shinchiryota/Circuit/README.md

# Circuit
2022以降の回路をまとめる

## [諸注意](諸注意)
+ [使用するソフトウェア](諸注意/使用するソフトウェア/readme.md)
+ [ファイル構成](諸注意/ファイル構成/readme.md)
+ [命名規則](諸注意/命名規則/readme.md)

## [2022](https://github.com/shinchiryota/Circuit/blob/main/2022/README.md)
+ servo_solenoidvalve_of_Tatebayashi

+ unitbase_keinz_2022

+ controller_keinz_2022
## [2023](https://github.com/shinchiryota/Circuit/blob/main/2023/README.md)
+ controller_keinz_2023

+ sensormain_of_sawada

+ servosolenoidvalve_of_tanbo

+ unitbase_anayuki
## [2024](https://github.com/shinchiryota/Circuit/blob/main/2024/README.md)
+ Power_of_Exodia

+ Unitbase_of_exoia
+ ### [nhk2024](https://github.com/shinchiryota/Circuit/blob/main/2024/nhk2024/README.md)
