shinchiryota/Circuit/2024/README.md

# 2024年度の回路
+ Power_of_Exodia
 
+ Unitbase_of_exodia
## [nhk2024](https://github.com/shinchiryota/Circuit/tree/main/2024/nhk2024)

# [始めに戻る](https://github.com/shinchiryota/Circuit/blob/main/README.md)
