shinchiryota/Circuit/2023/README.md

# 2023

# [始めに戻る](https://github.com/shinchiryota/Circuit/blob/main/README.md)
