shinchiryota/Circuit/諸注意/使用するソフトウェア/readme.md

# 使用するソフトウェア
---
## EAGLE
[ここ]() からダウンロードする。

詳細はGRCCの[回路資料]()を見ること。

サ終するのと、バグが頻繁に起きるのでインストールミスるひともいるかも。
## Kicad
[ここ](https://www.kicad.org/download/) からダウンロードする。

手順通り従えばインストールできるはず。

めっちゃ丁寧でわかりやすい。
