shinchiryota/Circuit/2024/nhk2024/README.md

# 高専ロボコン2024で使った回路
+ Controller 

+ Sensormain

+ Unitbase

+ Servosolenoidvalve

+ FEP02 

# [始めに戻る](https://github.com/shinchiryota/Circuit/blob/main/README.md)
