shinchiryota/Circuit/諸注意/readme.md

# 目次

+ [使用するソフトウェア](使用するソフトウェア/readme.md)
+ [ファイル構成](ファイル構成/readme.md)
+ [命名規則](命名規則/readme.md)
