shinchiryota/Circuit/2022/unitbase_keinz_2022/README.md

# Unitbase_Keinz_2022

高専ロボコン2022で使用されるUnitbase回路。  
現在の内容は印字等の修正が含まれているため部室にある回路とは厳密には異なる。  
部室にある回路のデータは、以下のcommitの中にある。  

commit #22d5f8b0ac3ca70e439e2381a5ce0f51943bfda6
