shinchiryota/Circuit/2024/Unitbase_of_exodia-main/README.md

# Unitbase_of_exodia
Unitbase_anayukiの改良版
