shinchiryota/Circuit/fep/Fep_Exodia/ver2/README.md

# FEP_of_Exodia
fep02用に新しく開発したfep基板です。god_of_fepを参考にしてます。

## 回路図
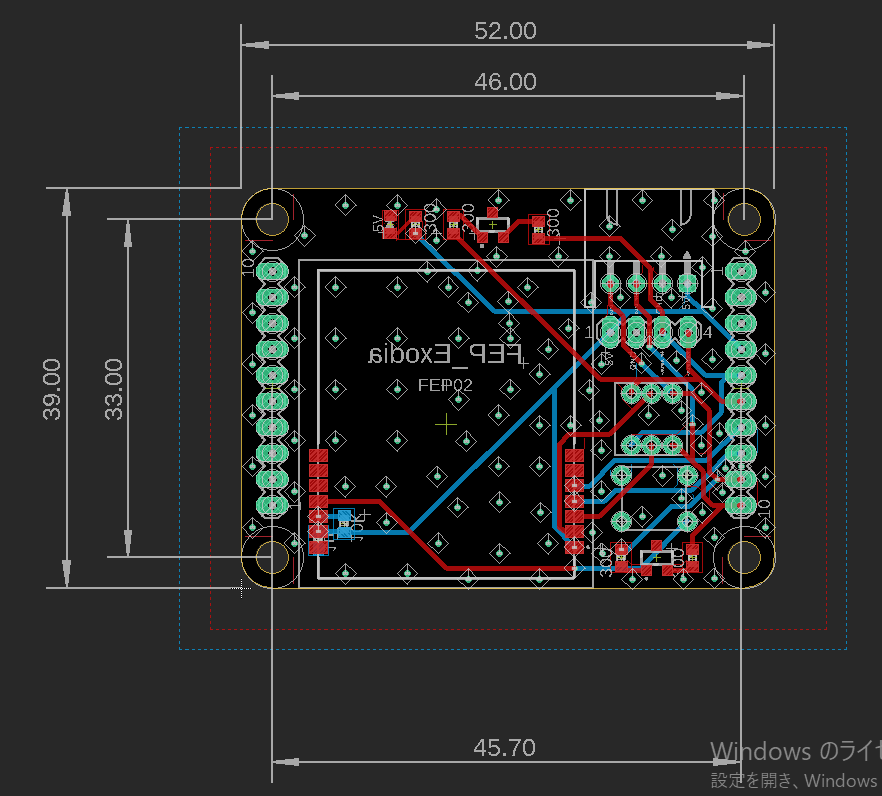
[picture p1: fep/Fep_Exodia/ver2/docs/fep_of_exodia.png]
brd_image


## スケマティック
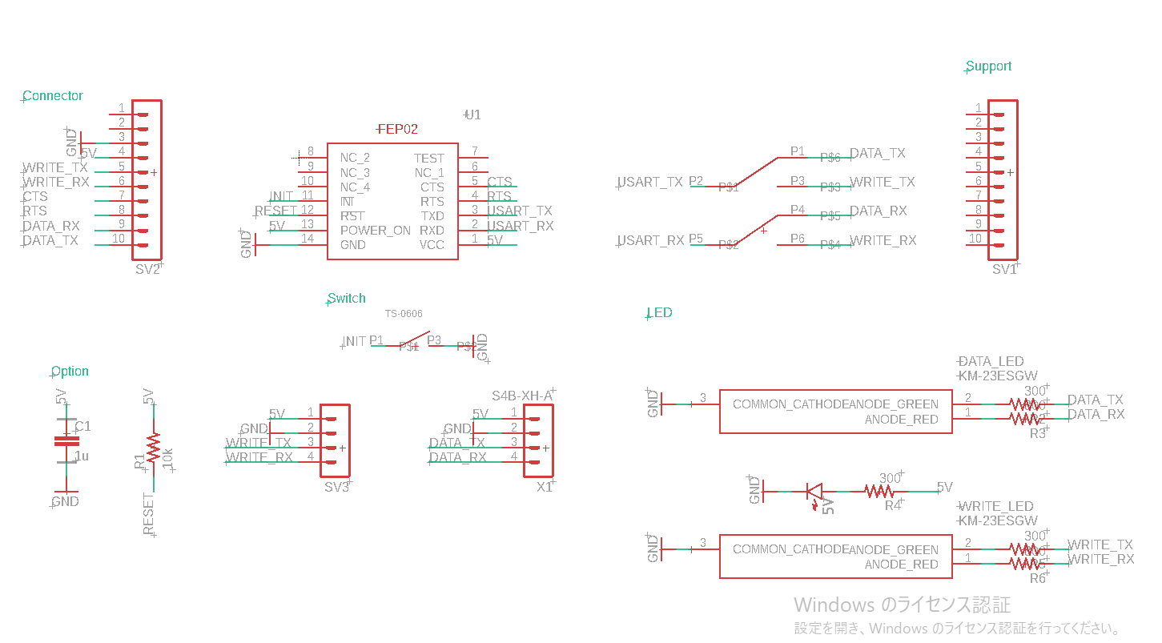
[picture p2: fep/Fep_Exodia/ver2/docs/fep_of_exodia_sch.png]
sch_image
