shinchiryota/Circuit/fep/god_of_fep/God_of_FEP_Parts.xlsx

Sheet: Parts_List
回路製作枚数 | 部品名 | ジャンル | 使用場所 | 購入場所 | URL | 単価 | 個数/枚 | 必要個数 | 合計金額 | その他 | １枚あたりの製作コスト
10 | FEP01 | FEP | 本体 |  |  |  | 1 | 10 | 0 |  | 1685
 | RED_LED | LED | 電源LED | 秋月電子 | URL (http://akizukidenshi.com/catalog/g/gI-03978/) | 10 | 1 | 10 | 100 | I-03978
 | KM-23YSGC | LED | チェックLED | 秋月電子 | URL (http://akizukidenshi.com/catalog/g/gI-06845/) | 10 | 2 | 20 | 200 | I-06845
 | S04B-XASK-1 | XAコネクタ | コネクタ部 | RS | URL (https://jp.rs-online.com/web/p/pcb-headers/6028228/) | 78.5 | 1 | 10 | 785
 | タクトスイッチ(赤色) | スイッチ |  | 秋月電子 | URL (http://akizukidenshi.com/catalog/g/gP-03646/) | 10 | 1 | 10 | 100 | P-03646
 | PS-70S_RED | スイッチ |  | 秋月電子 | URL (http://akizukidenshi.com/catalog/g/gP-08784/) | 50 | 1 | 10 | 500 | P-08784
 | 1uF | 表面実装コンデンサ |  | ウルト |  | 0 | 1 | 10 | 0
 | ピンヘッダ | ピンヘッダ | コネクタ部 | 秋月電子 |  |  |  | 0 | 0

Sheet: Data
部品名 | ジャンル | 購入場所 | URL | 単価 | その他
