shinchiryota/Circuit/2022/servo_solenoidvalve_of_Tatebayashi/Servosolenoidvalve_of_Tatebayashi.xlsx

回路製作枚数 | 部品名 | ジャンル | 使用場所 | 購入場所 | URL | 単価 | 個数/枚 | 必要個数 | 合計金額 | その他 | １枚あたりの製作コスト
2+3 | 0.1uコンデンサ |  |  |  |  |  | 6 | 30 |  |  | 0
 | 10nコンデンサ |  |  |  |  |  | 1 | 5
 | 10uコンデンサ |  |  |  |  |  | 1 | 5
 | 1uコンデンサ |  |  |  |  |  | 1 | 5
 | 4.7uコンデンサ |  |  |  |  |  | 1 | 5
 | 25PK470MEFC8X11.5 | 470u電解コンデンサー |  | 秋月電子 | URL (https://akizukidenshi.com/catalog/g/gP-03129/) | 20 | 1 | 5
 | 120抵抗 |  |  |  |  |  | 1 | 5
 | 300抵抗 |  |  |  |  |  | 20 | 100
 | 1k抵抗 |  |  |  |  |  | 83 | 415
 | 10k抵抗 |  |  |  |  |  | 18 | 90
 | 2SC2712GR | トランジスタNch |  | 秋月電子 | URL (https://akizukidenshi.com/catalog/g/gI-00761/) | 5 | 28 | 140
 | F302RBT6 | マイコン |  |  |  |  | 1 | 5
 | LD1117S33CTR | 3V3レギュレータ |  | チップワンストップ | URL (https://www.chip1stop.com/view/dispDetail/DispDetail?partId=STMI-0020157) | 96.2 | 1 | 5
 | NCV7351D1ER2G | CANトランシーバ |  |  |  |  | 1 | 5
 | TD62083AFG,N,EL | トランジスタアレイ |  | 秋月電子 | URL (https://akizukidenshi.com/catalog/g/gI-06227/) | 30 | 1 | 5
 | TLP293-4_GB | フォトカプラアレイ |  | 秋月電子 | URL (https://akizukidenshi.com/catalog/g/gI-16115/) | 60 | 5 | 25
 | USB2段メス |  |  |  |  |  | 1 | 5
 | XH2ピン縦 |  |  |  |  |  | 1 | 5
 | XH2ピン横 |  |  |  |  |  | 10 | 50
 | XH3ピン横 |  |  |  |  |  | 13 | 65
 | XH4ピン横 |  |  |  |  |  | 1 | 5
 | 青色LED |  |  |  |  |  | 6 | 30
 | 赤色LED |  |  |  |  |  | 4 | 20
 | 黄色LED |  |  |  |  |  | 21 | 105
 | 緑色LED |  |  |  |  |  | 21 | 105
 | タクトスイッチ |  |  |  |  |  | 1 | 5
 | ピンソケットL6 |  |  |  |  |  | 1 | 5
 | ピンヘッダ1*3 |  |  |  |  |  | 3 | 15
 | 小型高効率ＤＣＤＣコンバーター可変電源キット（降圧） |  |  | 秋月電子 | URL (https://akizukidenshi.com/catalog/g/gK-07728/) | 1280 | 1 | 5
