shinchiryota/Circuit/2024/nhk2024/Unitbase_chachamaru.ver4/unit_base.kicad_pcb

## KiCad design 2024/nhk2024/Unitbase_chachamaru.ver4/unit_base.kicad_pcb (2024-07-15)

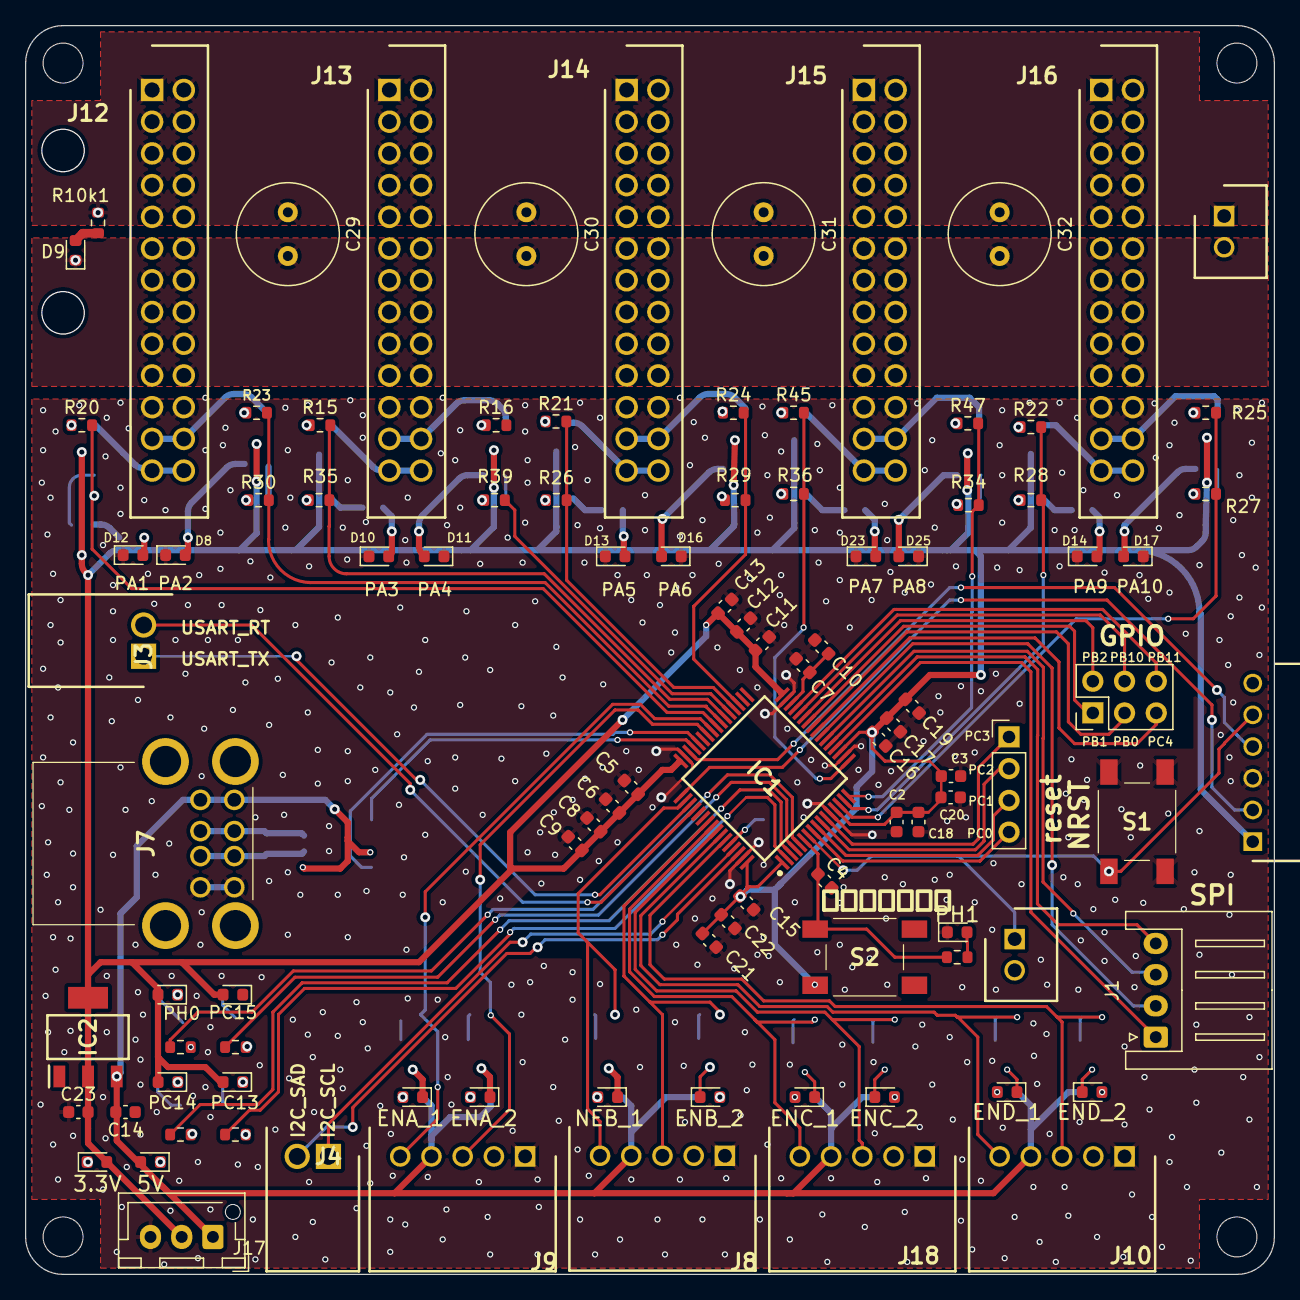
[picture p3: board unit_base.kicad_pcb from above]

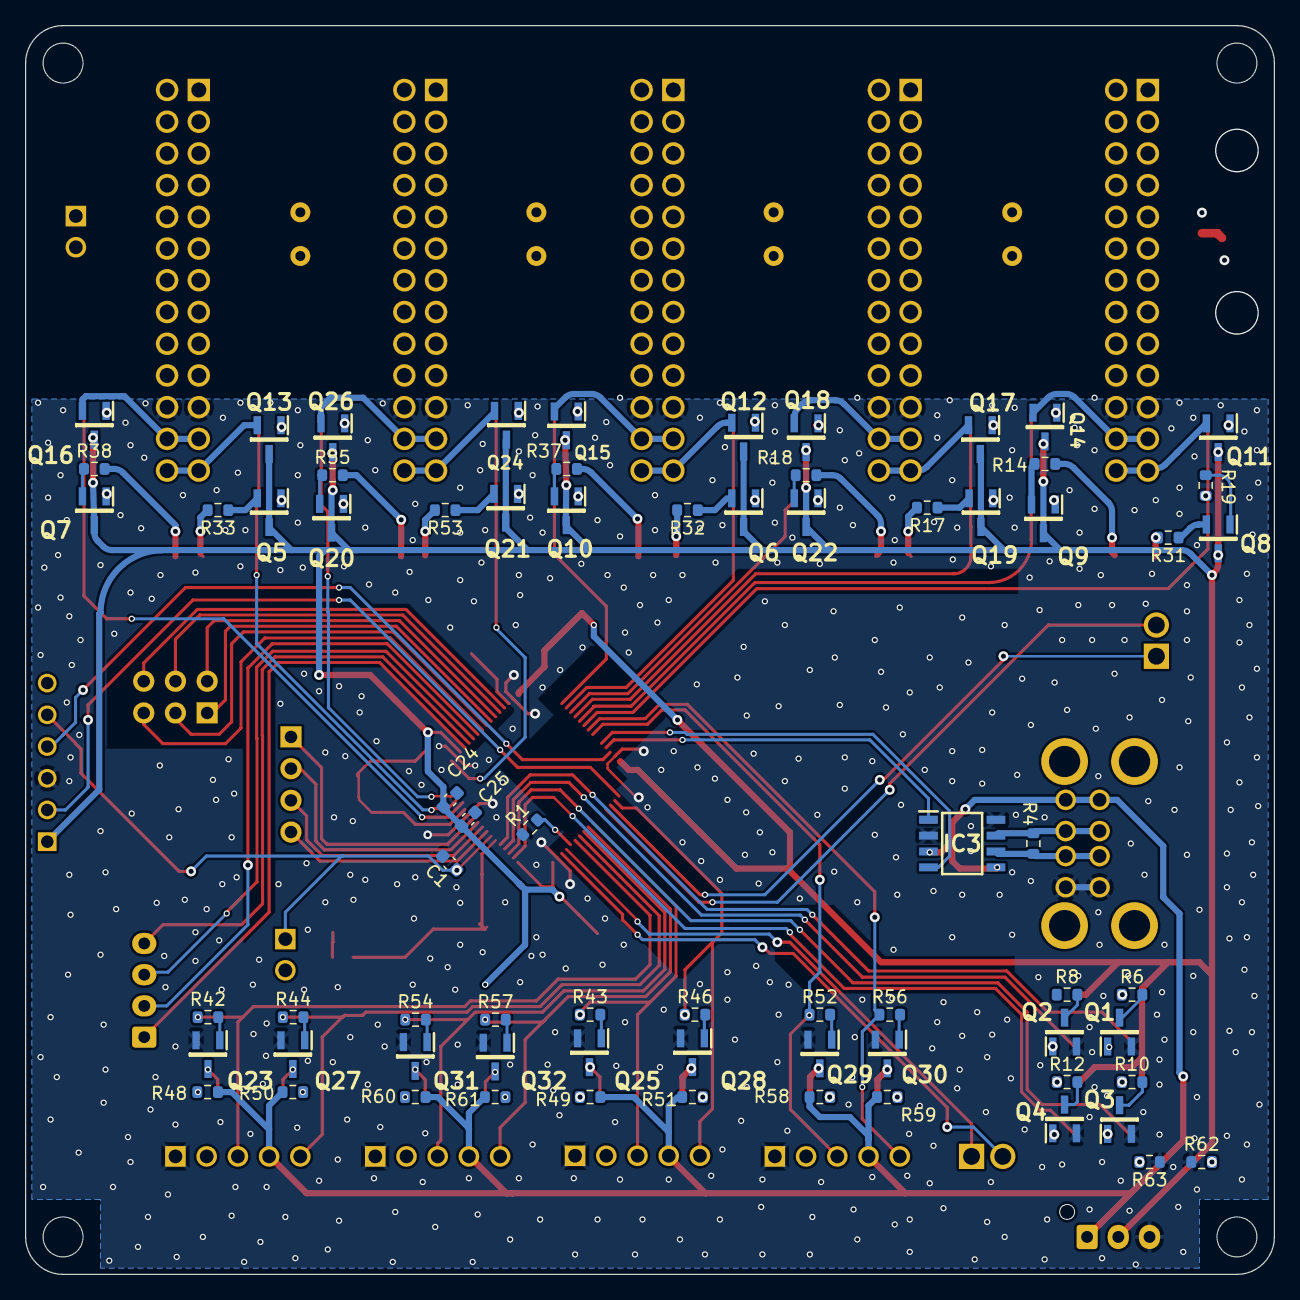
[picture p4: board unit_base.kicad_pcb from below]

Board: 2 copper layers, 100.0 x 100.0 mm, 169 parts (71 on the bottom side), 136 nets.

Parts:
3.3V, 5V: LED; LED_0603_1608Metric
C1, C4: C0.1u; C_0603_1608Metric
C2, C18, C24: 100n; C_0603_1608Metric
C3, C20, C25: 1u; C_0603_1608Metric
C5, C6, C8, C9, C11, C12, C13, C14, C15, C16, C17, C19: C100n; C_0603_1608Metric
C7, C10: C2.2u; C_0603_1608Metric
C21: C4.7u; C_0603_1608Metric
C22: 100u; C_0603_1608Metric
C23: C10u; C_0603_1608Metric
C29, C30, C31, C32: C; C_Radial_D8.0mm_H11.5mm_P3.50mm
D8, D9, D10, D11, D12, D13, D14, D16, D17, D23, D25: LED; LED_0603_1608Metric
ENA_1, ENA_2: LED; LED_0603_1608Metric
ENB_2: LED; LED_0603_1608Metric
ENC_1, ENC_2: LED; LED_0603_1608Metric
END_1, END_2: LED; LED_0603_1608Metric
IC1: STM32F732RET6; QFP50P1200X1200X160-64N
IC2: LM317_SOT-223_; SOT230P700X180-4N
IC3: NCV7351D1ER2G; SOIC127P600X175-8N
J1: S4B-XH-A_LF__SN_; JST_XH_S4B-XH-A_1x04_P2.50mm_Horizontal
J2, J11: B2B-XH-A; SHDR2W64P0X250_1X2_740X575X700P
J3, J4: S2B-XH-A_LF__SN_; SHDRRA2W80P0X250_1X2_740X1150X610P
J6: FH-1X06RG; RHDRRA6W58P0X254_1X6_1549X850X265P
J7: USB-4AF203AS; USB4AF203AS
J8, J9, J10, J18: S5B-XH-A_LF__SN_; SHDRRA5W64P0X250_1X5_1490X1150X610P
J12, J13, J14, J15, J16: HIF3FB-26DA-2.54DSA_71_; RHDR26W71P254_2X13_3759X600X980Pソケット
J17: B3B-XH-A; JST_XH_B3B-XH-AM_1x03_P2.50mm_Vertical
NEB_1: LED; LED_0603_1608Metric
PC13, PC14, PC15: LED; LED_0603_1608Metric
PH0, PH1: LED; LED_0603_1608Metric
Q1, Q2, Q3, Q4, Q5, Q6, Q7, Q8, Q9, Q10, Q11, Q12, Q13, Q14, Q15, Q16, Q17, Q18, Q19, Q20, Q21, Q22, Q23, Q24, Q25, Q26, Q27, Q28, Q29, Q30, Q31, Q32: 2SC2712-GR_TE85L,F; SOT95P260X156-3N
R1: R10k; R_0603_1608Metric
R2, R4, R6, R7, R8, R9, R10, R10k1, R11, R12, R13, R14, R15, R16, R17, R18, R19, R20, R21, R22, R23, R24, R25, R26, R27, R28, R29, R30, R31, R32, R33, R34, R35, R36, R37, R38, R39, R42, R43, R44, R45, R46, R47, R48, R49, R50, R51, R52, R53, R54, R55, R56, R57, R58, R59, R60, R61, R62, R63: R; R_0603_1608Metric
S1, S2: TSHA-T-2.5B2-19E; TSHAT25B219E

Connections:
3.3V: 3.3V.2 (A), C2.1, C3.1, C5.1, C6.1, C8.1, C9.1, C11.1, C12.1, C13.1, C15.1, C16.1, C17.1, C18.1, C19.1, C20.1, C21.1, C22.1, C23.2, C24.1, C25.1, IC1.1 (VBAT), IC1.13 (VREF+), IC1.19 (VDD_1), IC1.32 (VDD_2), IC1.48 (VDD_3), IC1.64 (VDD_4), IC2.2 (OUTPUT_1), IC2.4 (OUTPUT_2), J6.1, J17.2, PC13.2 (A), PC14.2 (A), PC15.2 (A), PH0.2 (A), Q5.3 (COLLECTOR), Q6.3 (COLLECTOR), Q7.3 (COLLECTOR), Q8.3 (COLLECTOR), Q9.3 (COLLECTOR), Q10.3 (COLLECTOR), Q11.3 (COLLECTOR), Q12.3 (COLLECTOR), Q13.3 (COLLECTOR), Q14.3 (COLLECTOR), Q15.3 (COLLECTOR), Q16.3 (COLLECTOR), Q17.3 (COLLECTOR), Q18.3 (COLLECTOR), Q19.3 (COLLECTOR), Q20.3 (COLLECTOR), Q21.3 (COLLECTOR), Q22.3 (COLLECTOR), Q24.3 (COLLECTOR), Q26.3 (COLLECTOR), S2.C1 (COM_1)
12V: C29.1, C30.1, C31.1, C32.1, J11.1, J12.1, J12.2, J12.3, J12.4, J12.5, J12.6, J12.7, J12.8, J12.9, J12.10, J13.1, J13.2, J13.3, J13.4, J13.5, J13.6, J13.7, J13.8, J13.9, J13.10, J14.1, J14.2, J14.3, J14.4, J14.5, J14.6, J14.7, J14.8, J14.9, J14.10, J15.1, J15.2, J15.3, J15.4, J15.5, J15.6, J15.7, J15.8, J15.9, J15.10, J16.1, J16.2, J16.3, J16.4, J16.5, J16.6, J16.7, J16.8, J16.9, J16.10, R10k1.2
12V_GND: C29.2, C30.2, C31.2, C32.2, D9.1 (K), J11.2, J12.11, J12.12, J12.13, J12.14, J12.15, J12.16, J12.17, J12.18, J12.19, J12.20, J13.11, J13.12, J13.13, J13.14, J13.15, J13.16, J13.17, J13.18, J13.19, J13.20, J14.11, J14.12, J14.13, J14.14, J14.15, J14.16, J14.17, J14.18, J14.19, J14.20, J15.11, J15.12, J15.13, J15.14, J15.15, J15.16, J15.17, J15.18, J15.19, J15.20, J16.11, J16.12, J16.13, J16.14, J16.15, J16.16, J16.17, J16.18, J16.19, J16.20
/5V: 5V.2 (A), C14.2, IC2.3 (INPUT), IC3.3 (VCC), IC3.5 (EN), J7.1, J7.5, J8.4, J9.4, J10.4, J17.1, J18.4, R48.2, R49.2, R50.2, R51.2, R58.2, R59.2, R60.2, R61.2
/5V_GND: C14.1, IC2.1 (ADJ)
/12V/PA1: J12.25, J12.26, Q11.2 (EMITTER)
/12V/PA2: J12.23, J12.24, Q14.2 (EMITTER)
/12V/PA3: J13.25, J13.26, Q17.2 (EMITTER)
/12V/PA4: J13.23, J13.24, Q18.2 (EMITTER)
/12V/PA5: J14.25, J14.26, Q12.2 (EMITTER)
/12V/PA6: J14.23, J14.24, Q15.2 (EMITTER)
/12V/PA7: J15.25, J15.26, Q24.2 (EMITTER)
/12V/PA8: J15.23, J15.24, Q26.2 (EMITTER)
/12V/PA9: J16.25, J16.26, Q13.2 (EMITTER)
/12V/PA10: J16.23, J16.24, Q16.2 (EMITTER)
/CAN1_RX: IC1.44 (PA11), IC3.4 (RXD)
/CAN1_TX: IC1.45 (PA12), IC3.1 (TXD)
/CANH: IC3.7 (CANH), J7.2, J7.6, R4.1
/CANL: IC3.6 (CANL), J7.3, J7.7, R4.2
/EncoderA_1: IC1.41 (PA8), J9.5, R56.1
/EncoderA_2: IC1.42 (PA9), J9.3, R52.1
/EncoderB_1: IC1.50 (PA15), J8.5, R46.1
/EncoderB_2: IC1.55 (PB3), J8.3, R43.1
/EncoderC_1: IC1.56 (PB4), J18.5, R57.1
/EncoderC_2: IC1.57 (PB5), J18.3, R54.1
/EncoderD_1: IC1.58 (PB6), J10.5, R44.1
/EncoderD_2: IC1.59 (PB7), J10.3, R42.1
/I2C1_SCL: IC1.61 (PB8), J4.1
/I2C1_SDA: IC1.62 (PB9), J4.2
/NRST: C1.1, IC1.7 (NRST), J2.1, J6.5, S1.A1 (NO_1)
/PH0: IC1.5 (PH0-OSC_IN), R7.2
/PH1: C4.1, IC1.6 (PH1-OSC_OUT), R2.2, S2.A1 (NO_1)
/SPI1_MISO: IC1.22 (PA6), J1.3
/SPI1_MOSI: IC1.23 (PA7), J1.2
/SPI1_NSS: IC1.20 (PA4), J1.1
/SPI1_SCK: IC1.21 (PA5), J1.4
/SWCLK: IC1.49 (PA14), J6.2
/SWDIO: IC1.46 (PA13), J6.4
/UART4_RT: IC1.52 (PC11), J3.2
/UART4_TX: IC1.51 (PC10), J3.1
/VCAP: C7.1, C10.1, IC1.30 (VCAP_1)
GND: C1.2, C2.2, C3.2, C4.2, C5.2, C6.2, C7.2, C8.2, C9.2, C10.2, C11.2, C12.2, C13.2, C15.2, C16.2, C17.2, C18.2, C19.2, C20.2, C21.2, C22.2, C23.1, D8.1 (K), D10.1 (K), D11.1 (K), D12.1 (K), D13.1 (K), D14.1 (K), D16.1 (K), D17.1 (K), D23.1 (K), D25.1 (K), IC1.12 (VSSA), IC1.18 (VSS_1), IC1.31 (VSS_2), IC1.47 (VSS_3), IC1.63 (VSS_4), IC3.2 (GND), IC3.8 (S), J6.3, J7.4, J7.8, J8.1, J9.1, J10.1, J12.21, J12.22, J13.21, J13.22, J14.21, J14.22, J15.21, J15.22, J16.21, J16.22, J17.3, J18.1, PH1.1 (K), Q1.2 (EMITTER), Q2.2 (EMITTER), Q3.2 (EMITTER), Q4.2 (EMITTER), Q23.2 (EMITTER), Q25.2 (EMITTER), Q27.2 (EMITTER), Q28.2 (EMITTER), Q29.2 (EMITTER), Q30.2 (EMITTER), Q31.2 (EMITTER), Q32.2 (EMITTER), R1.1, R62.1, R63.1, S1.B1 (NO_2), S1.C1 (COM_1), S1.D1 (COM_2)
MDA_1: IC1.40 (PC9), R19.2, R20.2
MDA_2: IC1.39 (PC8), R23.2, R30.2
MDB_1: IC1.38 (PC7), R15.2, R35.2
MDB_2: IC1.37 (PC6), R16.2, R39.2
MDC_1: IC1.36 (PB15), R21.2, R26.2
MDC_2: IC1.35 (PB14), R24.2, R29.2
MDD_1: IC1.17 (PA3), R36.2, R45.2
MDD_2: IC1.16 (PA2), R34.2, R47.2
MDE_1: IC1.15 (PA1), R22.2, R28.2
MDE_2: IC1.14 (PA0-WKUP), R25.2, R27.2
unnamed: PH1.2 (A), R2.1
unnamed: PH0.1 (K), R6.1
unnamed: PC15.1 (K), R8.1
unnamed: PC14.1 (K), R10.1
unnamed: PC13.1 (K), R12.1
unnamed: D8.2 (A), R14.2
unnamed: D9.2 (A), R10k1.1
unnamed: D10.2 (A), R17.2
unnamed: D11.2 (A), R18.2
unnamed: D12.2 (A), R31.2
unnamed: D13.2 (A), R32.2
unnamed: D14.2 (A), R33.2
unnamed: D16.2 (A), R37.2
unnamed: D17.2 (A), R38.2
unnamed: END_2.2 (A), R48.1
unnamed: END_2.1 (K), Q23.3 (COLLECTOR)
unnamed: ENB_2.2 (A), R49.1
unnamed: ENB_2.1 (K), Q25.3 (COLLECTOR)
unnamed: END_1.2 (A), R50.1
unnamed: END_1.1 (K), Q27.3 (COLLECTOR)
unnamed: NEB_1.2 (A), R51.1
unnamed: NEB_1.1 (K), Q28.3 (COLLECTOR)
unnamed: D23.2 (A), R53.2
unnamed: ENA_2.2 (A), R58.1
unnamed: ENA_2.1 (K), Q29.3 (COLLECTOR)
unnamed: D25.2 (A), R55.2
unnamed: ENA_1.2 (A), R59.1
unnamed: ENA_1.1 (K), Q30.3 (COLLECTOR)
unnamed: ENC_2.2 (A), R60.1
unnamed: ENC_2.1 (K), Q31.3 (COLLECTOR)
unnamed: ENC_1.2 (A), R61.1
unnamed: ENC_1.1 (K), Q32.3 (COLLECTOR)
unnamed: 3.3V.1 (K), R62.2
unnamed: 5V.1 (K), R63.2
unnamed: IC1.60 (BOOT0), R1.2
unnamed: Q1.1 (BASE), R7.1
unnamed: Q1.3 (COLLECTOR), R6.2
unnamed: Q2.1 (BASE), R9.1
unnamed: Q2.3 (COLLECTOR), R8.2
unnamed: Q3.1 (BASE), R11.1
unnamed: Q3.3 (COLLECTOR), R10.2
unnamed: Q4.1 (BASE), R13.1
unnamed: Q4.3 (COLLECTOR), R12.2
unnamed: Q5.1 (BASE), R28.1
unnamed: Q5.2 (EMITTER), R33.1
unnamed: Q6.1 (BASE), R26.1
unnamed: Q6.2 (EMITTER), R32.1
unnamed: Q7.1 (BASE), R27.1
unnamed: Q7.2 (EMITTER), R38.1
unnamed: Q8.1 (BASE), R19.1
unnamed: Q8.2 (EMITTER), R31.1
unnamed: Q9.1 (BASE), R30.1
unnamed: Q9.2 (EMITTER), R14.1
unnamed: Q10.1 (BASE), R29.1
unnamed: Q10.2 (EMITTER), R37.1
unnamed: Q11.1 (BASE), R20.1
unnamed: Q12.1 (BASE), R21.1
unnamed: Q13.1 (BASE), R22.1
unnamed: Q14.1 (BASE), R23.1
unnamed: Q15.1 (BASE), R24.1
unnamed: Q16.1 (BASE), R25.1
unnamed: Q17.1 (BASE), R15.1
unnamed: Q18.1 (BASE), R16.1
unnamed: Q19.1 (BASE), R35.1
unnamed: Q19.2 (EMITTER), R17.1
unnamed: Q20.1 (BASE), R34.1
unnamed: Q20.2 (EMITTER), R55.1
unnamed: Q21.1 (BASE), R36.1
unnamed: Q21.2 (EMITTER), R53.1
unnamed: Q22.1 (BASE), R39.1
unnamed: Q22.2 (EMITTER), R18.1
unnamed: Q23.1 (BASE), R42.2
unnamed: Q24.1 (BASE), R45.1
unnamed: Q25.1 (BASE), R43.2
unnamed: Q26.1 (BASE), R47.1
unnamed: Q27.1 (BASE), R44.2
unnamed: Q28.1 (BASE), R46.2
unnamed: Q29.1 (BASE), R52.2
unnamed: Q30.1 (BASE), R56.2
unnamed: Q31.1 (BASE), R54.2
unnamed: Q32.1 (BASE), R57.2
PC13: IC1.2 (PC13), R13.2
PC14: IC1.3 (PC14-OSC32_IN), R11.2
PC15: IC1.4 (PC15-OSC32_OUT), R9.2
