shinchiryota/Circuit/2024/MD_Tanukiti/mD.kicad_pcb

## KiCad design 2024/MD_Tanukiti/mD.kicad_pcb (2024-06-25)

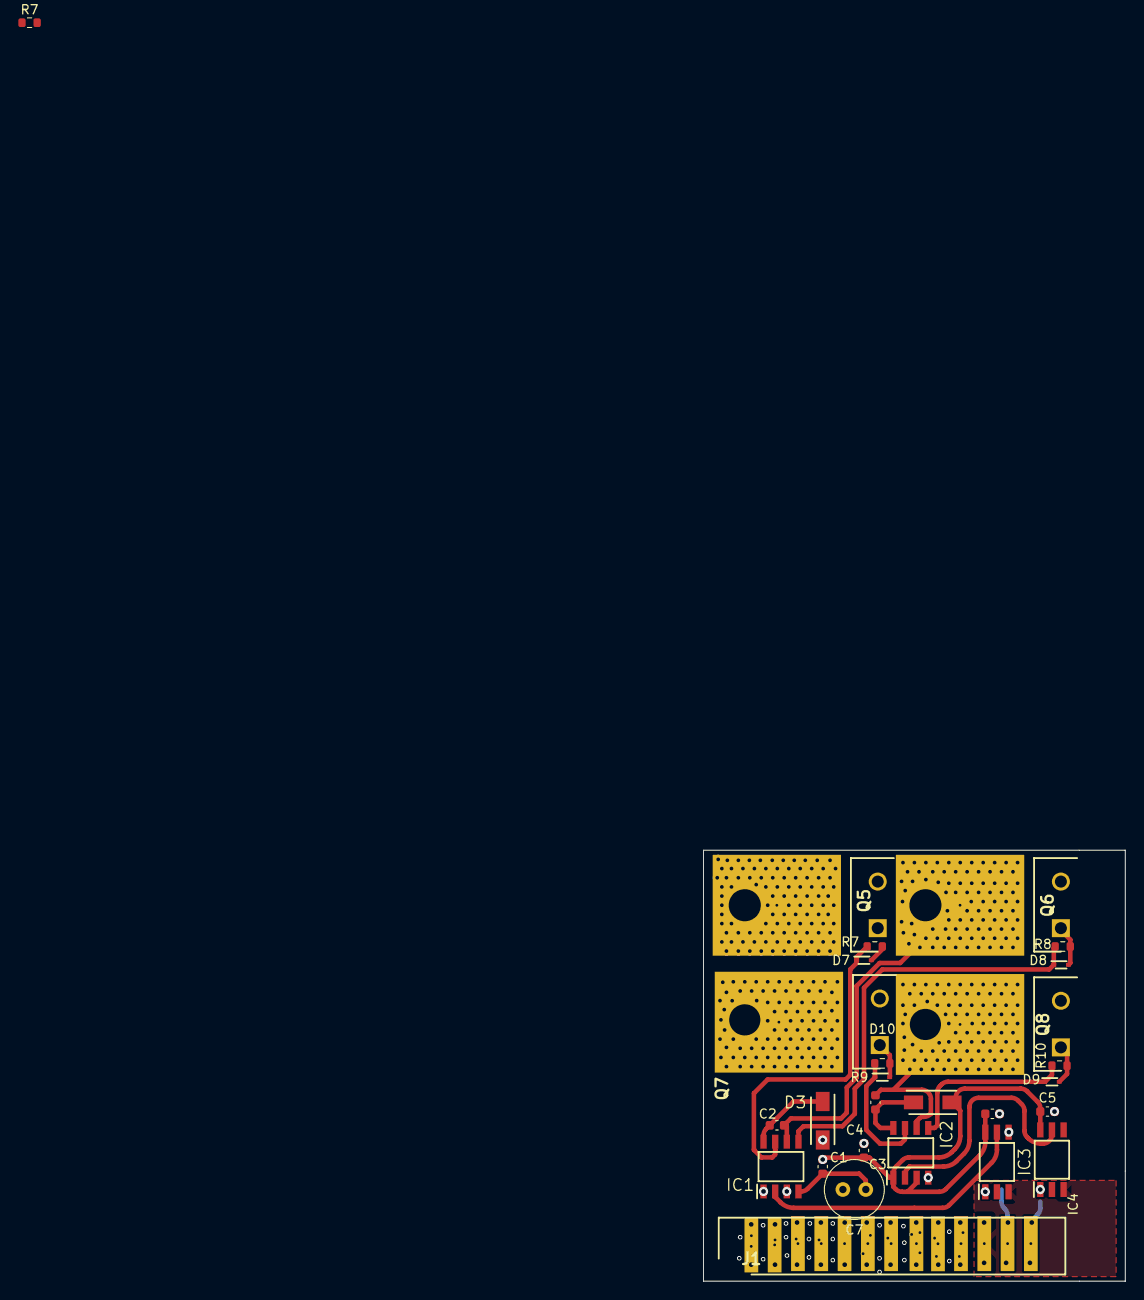
[picture p5: board mD.kicad_pcb from above]

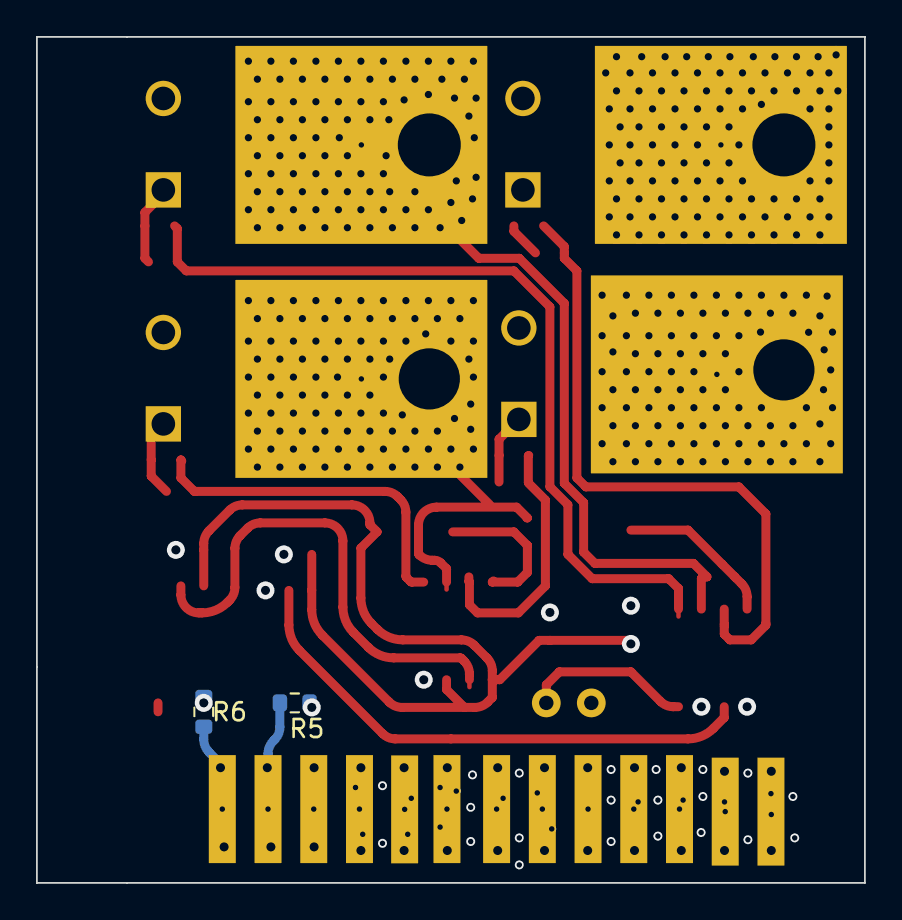
[picture p6: board mD.kicad_pcb from below]

Board: 2 copper layers, 46.0 x 47.0 mm, 29 parts (2 on the bottom side), 22 nets.

Parts:
C1: C_1u; C_0603_1608Metric
C2, C4: C0.1u; C_0603_1608Metric
C3: C1u; C_0603_1608Metric
C5, C6: 0.1u; C_0603_1608Metric
C7: 100uF; C_Radial_D6.3mm_H11.0mm_P2.50mm
D3, D6: SS14; DIOM5126X250N
D7, D8, D9, D10: BAT43; SODFL1608X70N
IC1, IC2: IRS2008SPBF; SOIC127P600X175-8N
IC3, IC4: TLP152_E_T; SOIC127P700X220-6N
J1: HIF3FB-26DA-2.54DSA_71_; RHDR26W71P254_2X13_3759X600X980P
Q5, Q6, Q7, Q8: EKI04027; eki04027
R5, R6: R150; R_0603_1608Metric
R7, R7#2, R8, R9, R10: 1k; R_0603_1608Metric

Connections:
/12V: C1.1, C3.1, C5.1, C6.1, C7.2, D3.2 (A), D6.2 (A), IC1.1 (VCC), IC1.3 (~SD), IC2.1 (VCC), IC2.3 (~SD), IC3.6 (VCC), IC4.6 (VCC), J1.1, J1.4, J1.6, J1.8, J1.10, Q5.2, Q7.2
/12V_GND: J1.12, J1.14, J1.16, J1.18, J1.20, Q6.3, Q8.3
/GND: IC3.3 (CATHODE), IC4.3 (CATHODE), J1.22
/GND_12V: C1.2, C3.2, C5.2, C6.2, C7.1, IC1.4 (COM), IC2.4 (COM), IC3.4 (GND), IC4.4 (GND)
/LH: D7.1 (K), IC1.7 (HO), R7.2, R7#2.2
/LIN: IC1.2 (IN), IC3.5 (VO)
/LL: D8.1 (K), IC1.5 (LO), R8.1
/LS: C2.2, IC1.6 (VS), Q5.3, Q6.2
/PWML: J1.24, R5.2
/PWMR: J1.26, R6.2
/RH: D10.1 (K), IC2.7 (HO), R9.2
/RIN: IC2.2 (IN), IC4.5 (VO)
/RL: D9.1 (K), IC2.5 (LO), R10.2
/RS: C4.2, IC2.6 (VS), Q7.3, Q8.2
unnamed: C2.1, D3.1 (K), IC1.8 (VB)
unnamed: C4.1, D6.1 (K), IC2.8 (VB)
unnamed: D7.2 (A), Q5.1, R7.1, R7#2.1
unnamed: D8.2 (A), Q6.1, R8.2
unnamed: D9.2 (A), Q8.1, R10.1
unnamed: D10.2 (A), Q7.1, R9.1
unnamed: IC3.1 (ANODE), R5.1
unnamed: IC4.1 (ANODE), R6.1
