shinchiryota/Circuit/fep/Fep_Exodia/ver1/FEP_Exodia.brd

## EAGLE design fep/Fep_Exodia/ver1/FEP_Exodia.brd (2024-06-25, an earlier design)

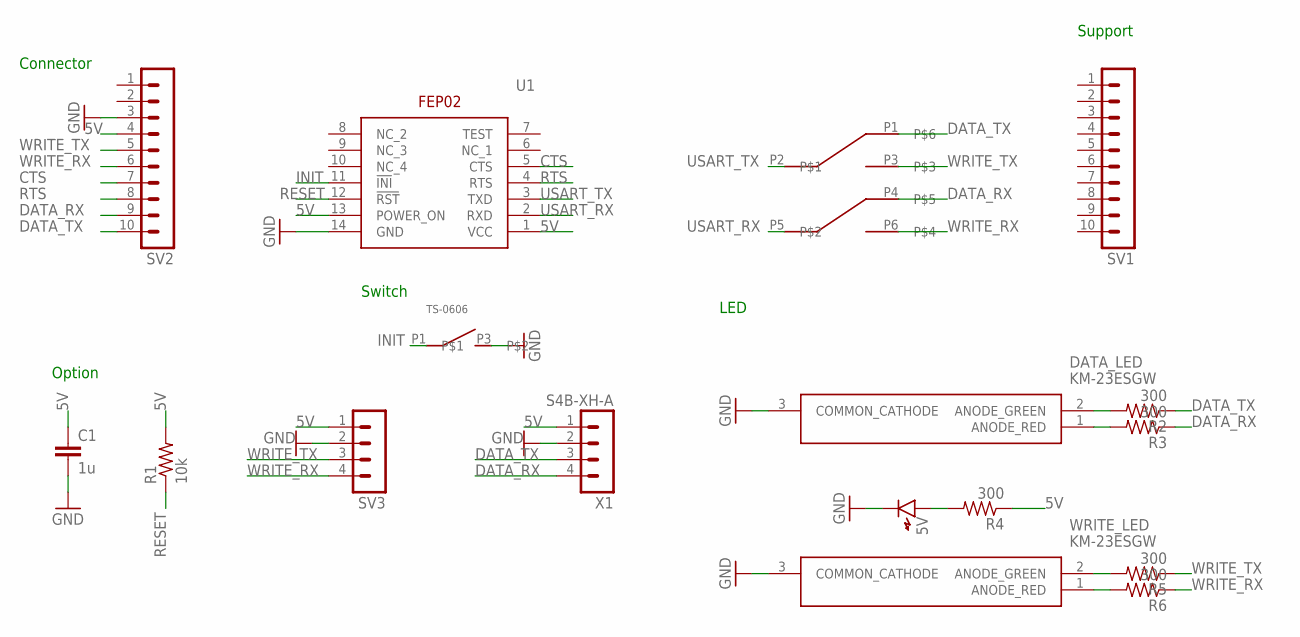
[picture p7: schematic FEP_Exodia.sch]

Parts:
5V: LED1608
C1: 1u; C0603
DATA_LED: KM-23ESGW; SOT-23
R1: 10k; R0603
R2, R3, R4, R5, R6: 300; R0603
SV1, SV2: MA10-1
SV3: MA04-1
SW_1: P-03647_TS-0606; TS-0606
SW_3: P-08784_PS-70S; PS-70S
U1: FEP02
WRITE_LED: KM-23ESGW; SOT-23
X1: S4B-XH-A

Connections:
5V: C1.1, R1.2, R4.1, SV2.4, SV3.1, U1.1 (VCC), U1.13 (POWER_ON), X1.1
CTS: SV2.7, U1.5 (CTS)
DATA_RX: R3.1, SV2.9, SW_3.P4, X1.4
DATA_TX: R2.1, SV2.10, SW_3.P1, X1.3
GND: 5V.K, C1.2, DATA_LED.3 (COMMON_CATHODE), SV2.3, SV3.2, SW_1.P3, U1.14 (GND), WRITE_LED.3 (COMMON_CATHODE), X1.2
INIT: SW_1.P1, U1.11 (!INI)
unnamed: DATA_LED.1 (ANODE_RED), R3.2
unnamed: DATA_LED.2 (ANODE_GREEN), R2.2
unnamed: 5V.A, R4.2
unnamed: R6.2, WRITE_LED.1 (ANODE_RED)
unnamed: R5.2, WRITE_LED.2 (ANODE_GREEN)
RESET: R1.1, U1.12 (!RST)
RTS: SV2.8, U1.4 (RTS)
USART_RX: SW_3.P5, U1.2 (RXD)
USART_TX: SW_3.P2, U1.3 (TXD)
WRITE_RX: R6.1, SV2.6, SV3.4, SW_3.P6
WRITE_TX: R5.1, SV2.5, SV3.3, SW_3.P3

Notes on the sheet:
Connector
Support
Switch
LED
Option

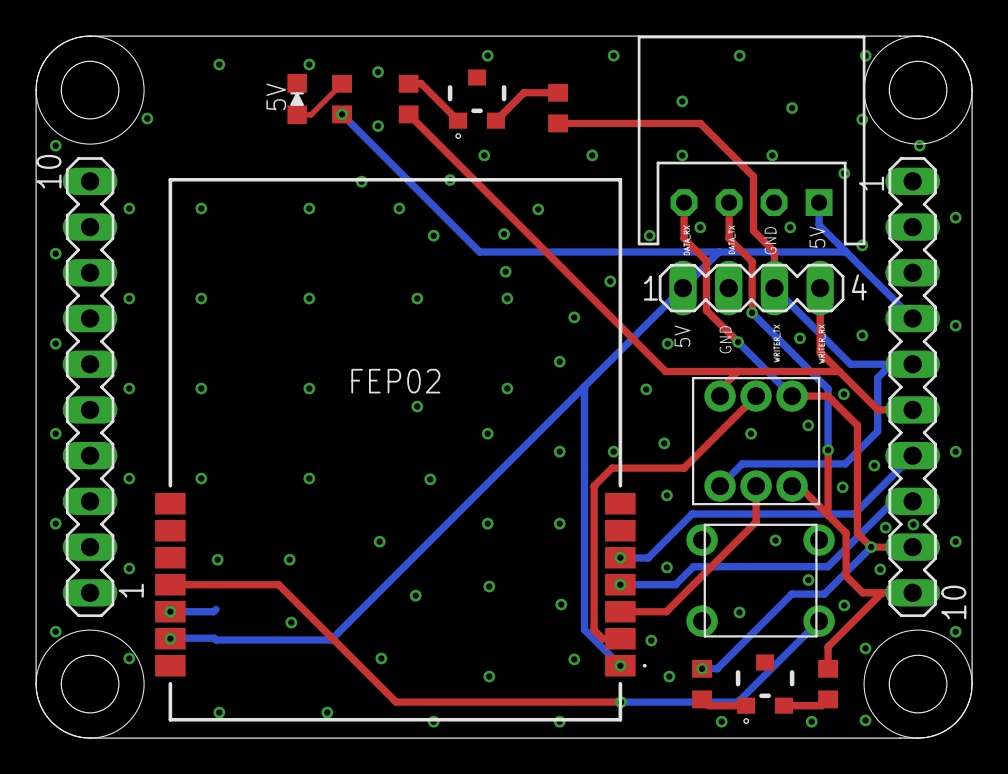
[picture p8: board FEP_Exodia.brd from above]

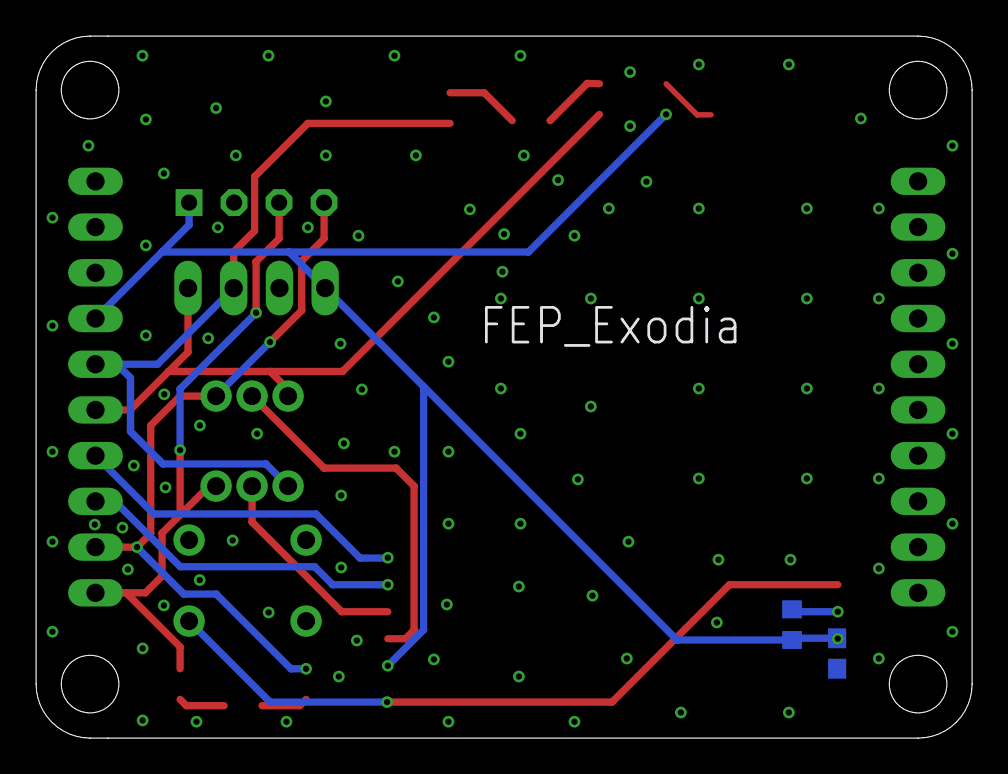
[picture p9: board FEP_Exodia.brd from below]

Board: 2 copper layers, 52.0 x 39.0 mm, 17 parts (2 on the bottom side), 17 nets.
