shinchiryota/Circuit/fep/god_of_fep/FEP.brd

## EAGLE design fep/god_of_fep/FEP.brd (2024-08-27)

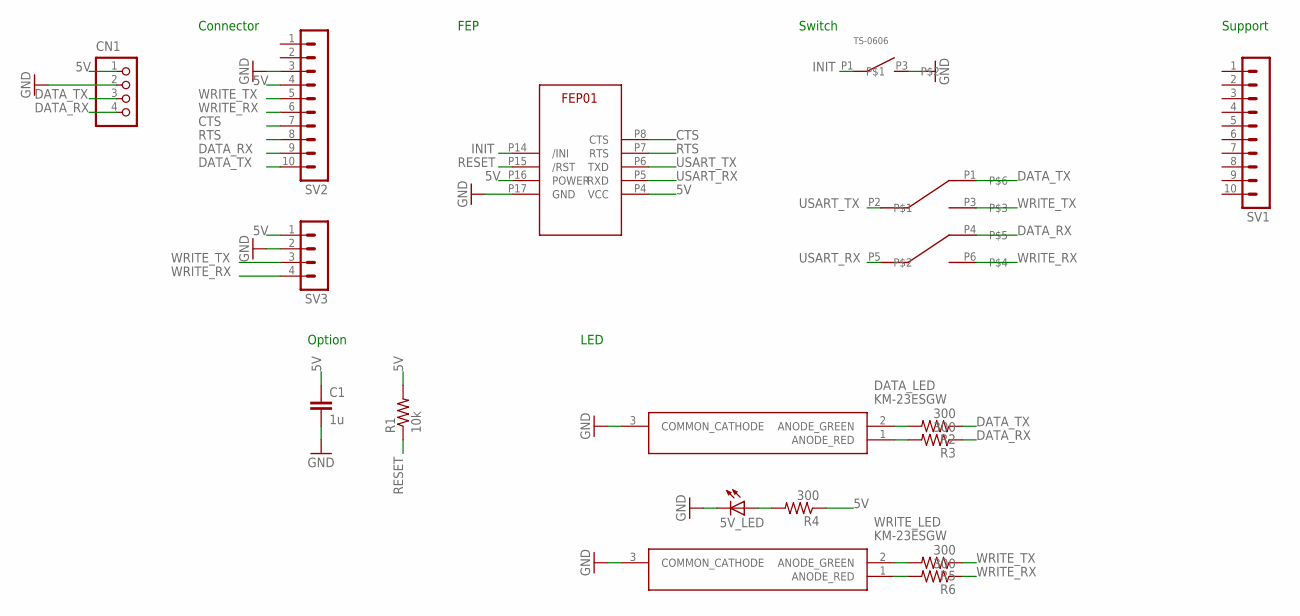
[picture p10: schematic FEP.sch]

Parts:
5V_LED: LED_E; LED_1206
C1: 1u; C0603
CN1: S4B-XASK-1
DATA_LED: KM-23ESGW; SOT-23
FEP_1: FEP01
R1: 10k; R0603
R2, R3, R4, R5, R6: 300; R0603
SV1, SV2: MA10-1
SV3: MA04-1
SW_1: P-03647_TS-0606; TS-0606
SW_3: P-08784_PS-70S; PS-70S
WRITE_LED: KM-23ESGW; SOT-23

Connections:
5V: C1.1, CN1.1, FEP_1.P4 (VCC), FEP_1.P16 (POWER), R1.2, R4.1, SV2.4, SV3.1
CTS: FEP_1.P8 (CTS), SV2.7
DATA_RX: CN1.4, R3.1, SV2.9, SW_3.P4
DATA_TX: CN1.3, R2.1, SV2.10, SW_3.P1
GND: 5V_LED.C, C1.2, CN1.2, DATA_LED.3 (COMMON_CATHODE), FEP_1.P17 (GND), SV2.3, SV3.2, SW_1.P3, WRITE_LED.3 (COMMON_CATHODE)
INIT: FEP_1.P14 (/INI), SW_1.P1
unnamed: DATA_LED.1 (ANODE_RED), R3.2
unnamed: DATA_LED.2 (ANODE_GREEN), R2.2
unnamed: 5V_LED.A, R4.2
unnamed: R6.2, WRITE_LED.1 (ANODE_RED)
unnamed: R5.2, WRITE_LED.2 (ANODE_GREEN)
RESET: FEP_1.P15 (/RST), R1.1
RTS: FEP_1.P7 (RTS), SV2.8
USART_RX: FEP_1.P5 (RXD), SW_3.P5
USART_TX: FEP_1.P6 (TXD), SW_3.P2
WRITE_RX: R6.1, SV2.6, SV3.4, SW_3.P6
WRITE_TX: R5.1, SV2.5, SV3.3, SW_3.P3

Notes on the sheet:
Connector
FEP
Switch
Option
LED
Support

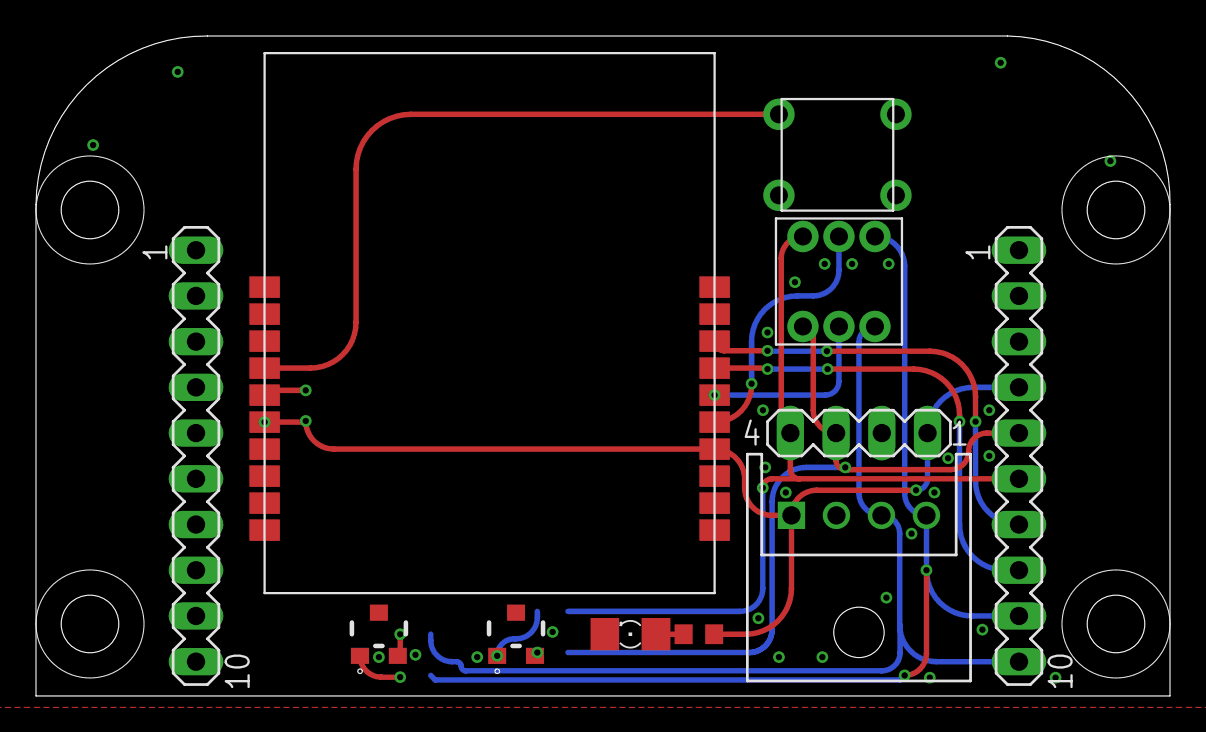
[picture p11: board FEP.brd from above]

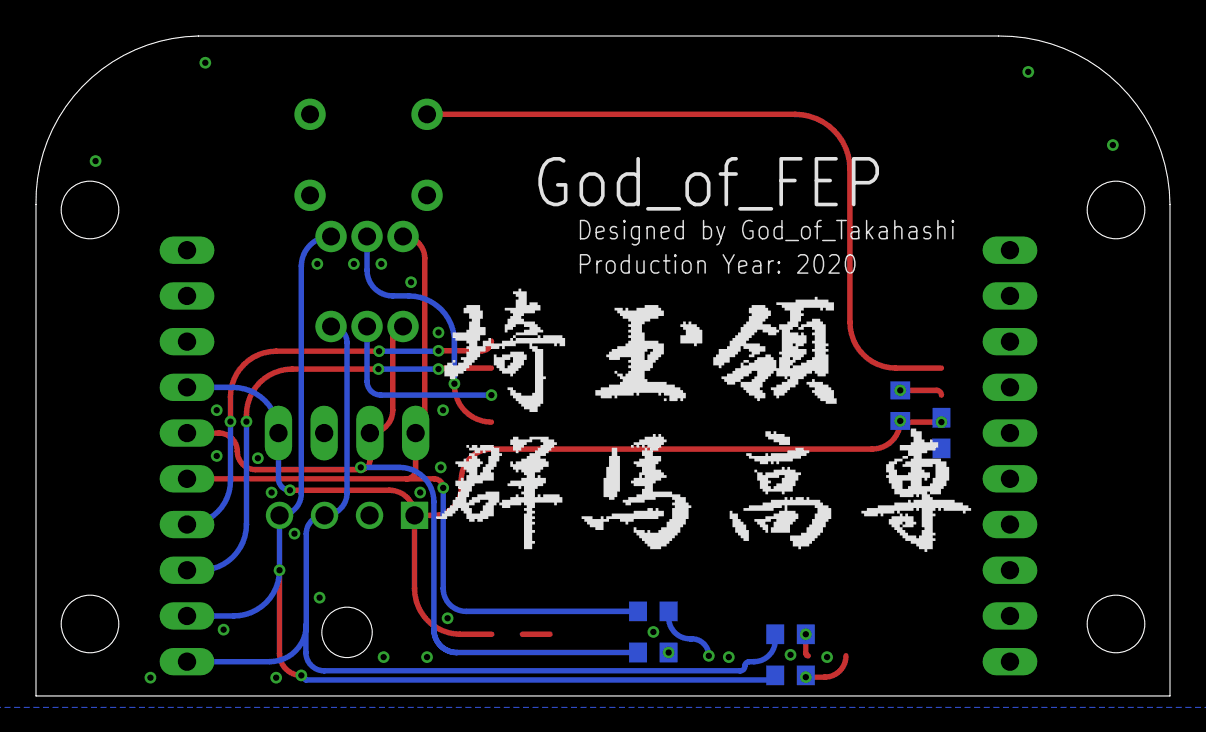
[picture p12: board FEP.brd from below]

Board: 2 copper layers, 63.0 x 36.7 mm, 17 parts (6 on the bottom side), 17 nets.
