shinchiryota/Circuit/2023/controller_keinz_2023-main/Controller_Keinz_2023.brd

## EAGLE design 2023/controller_keinz_2023-main/Controller_Keinz_2023.brd (2024-02-17)

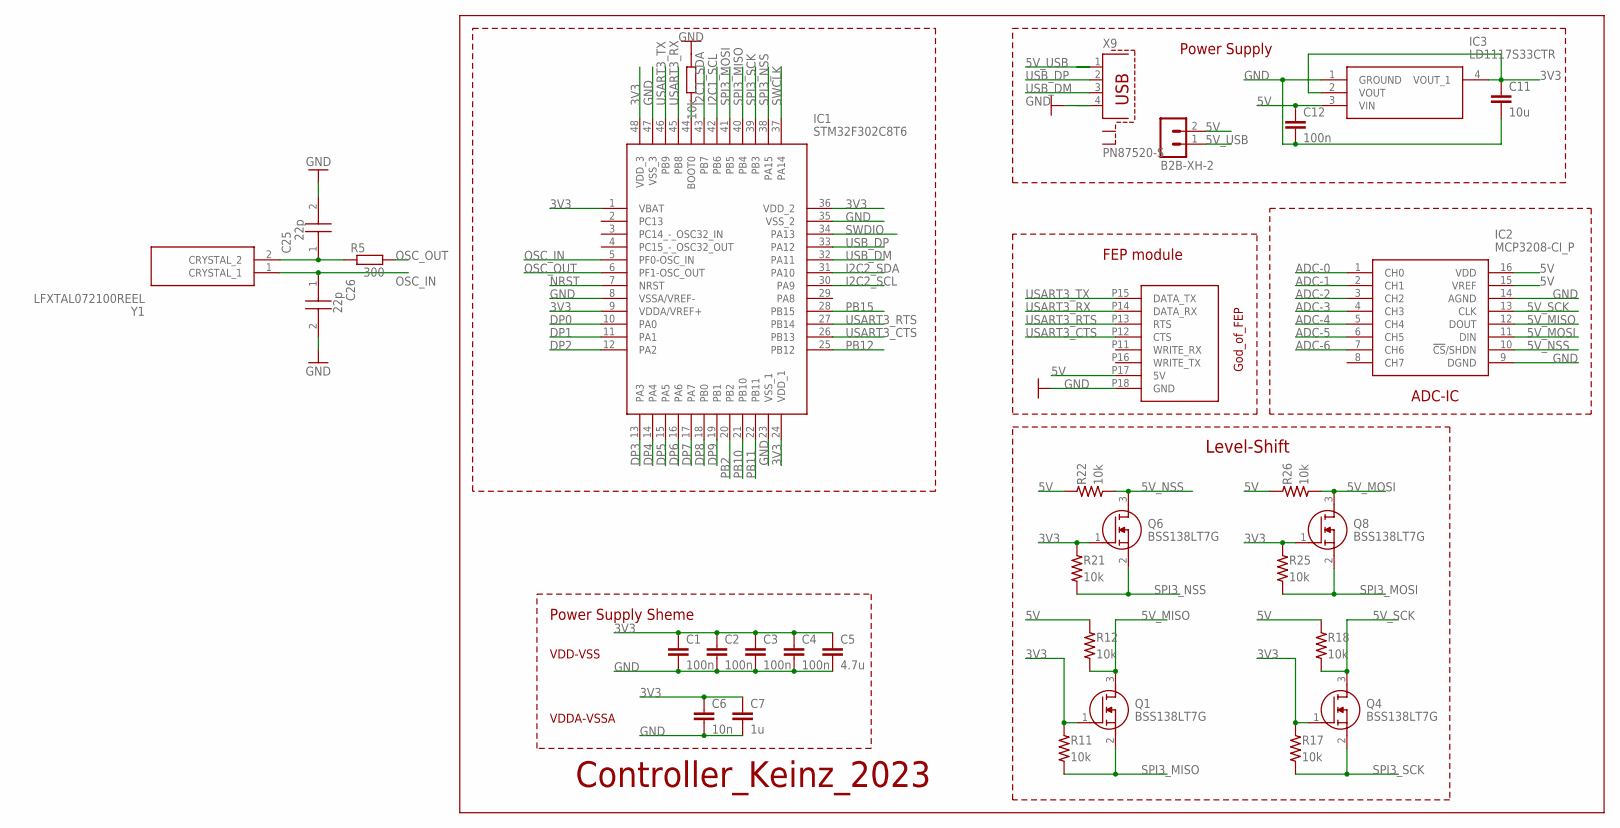
[picture p25: schematic Controller_Keinz_2023.sch, sheet 1]

Parts:
C1, C2, C3, C4, C12: 100n; C0603K
C5: 4.7u; C0603K
C6: 10n; C0603K
C7: 1u; C0603K
C11: 10u; C0603K
C25, C26: 22p; CAPC1709X100N
FEP_1: GOD_OF_FEP
IC1: STM32F302C8T6; QFP50P900X900X160-48N
IC2: MCP3208-CI_P; DIP781W56P254L1918H533Q16N
IC3: LD1117S33CTR; SOT230P700X190-4N
Q1, Q4, Q6, Q8: BSS138LT7G; SOT96P237X111-3N
R5: 300; 1608
R8: 10k; R0603
R11, R12, R17, R18, R21, R22, R25, R26: 10k; SMD1608
X9: PN87520-S
X22: B2B-XH-2; B2B-XH-A
Y1: LFXTAL072100REEL

Connections:
3V3: C1.1, C2.1, C3.1, C4.1, C5.1, C6.1, C7.1, C11.1, IC1.1 (VBAT), IC1.9 (VDDA/VREF+), IC1.24 (VDD_1), IC1.36 (VDD_2), IC1.48 (VDD_3), IC3.2 (VOUT), IC3.4 (VOUT_1), Q1.1 (G), Q4.1 (G), Q6.1 (G), Q8.1 (G), R11.1, R17.1, R21.1, R25.1; also elsewhere on the board
5V: C12.1, FEP_1.P17 (5V), IC2.15 (VREF), IC2.16 (VDD), IC3.3 (VIN), R12.1, R18.1, R22.1, R26.1, X22.2; also elsewhere on the board
5V_MISO: IC2.12 (DOUT), Q1.3 (D), R12.2
5V_MOSI: IC2.11 (DIN), Q8.3 (D), R26.2
5V_NSS: IC2.10 (!CS!/SHDN), Q6.3 (D), R22.2
5V_SCK: IC2.13 (CLK), Q4.3 (D), R18.2
5V_USB: X9.1, X22.1
ADC-0: IC2.1 (CH0); also elsewhere on the board
ADC-1: IC2.2 (CH1); also elsewhere on the board
ADC-2: IC2.3 (CH2); also elsewhere on the board
ADC-3: IC2.4 (CH3); also elsewhere on the board
ADC-4: IC2.5 (CH4); also elsewhere on the board
ADC-5: IC2.6 (CH5); also elsewhere on the board
ADC-6: IC2.7 (CH6); also elsewhere on the board
DP0: IC1.10 (PA0); also elsewhere on the board
DP1: IC1.11 (PA1); also elsewhere on the board
DP2: IC1.12 (PA2); also elsewhere on the board
DP3: IC1.13 (PA3); also elsewhere on the board
DP4: IC1.14 (PA4); also elsewhere on the board
DP5: IC1.15 (PA5); also elsewhere on the board
DP6: IC1.16 (PA6); also elsewhere on the board
DP7: IC1.17 (PA7); also elsewhere on the board
DP8: IC1.18 (PB0); also elsewhere on the board
DP9: IC1.19 (PB1); also elsewhere on the board
GND: C1.2, C2.2, C3.2, C4.2, C5.2, C6.2, C7.2, C11.2, C12.2, C25.2, C26.2, FEP_1.P18 (GND), IC1.8 (VSSA/VREF-), IC1.23 (VSS_1), IC1.35 (VSS_2), IC1.47 (VSS_3), IC2.9 (DGND), IC2.14 (AGND), IC3.1 (GROUND), R8.1, X9.4; also elsewhere on the board
I2C1_SCL: IC1.42 (PB6); also elsewhere on the board
I2C1_SDA: IC1.43 (PB7); also elsewhere on the board
I2C2_SCL: IC1.30 (PA9); also elsewhere on the board
I2C2_SDA: IC1.31 (PA10); also elsewhere on the board
unnamed: C25.1, R5.1, Y1.2 (CRYSTAL_2)
unnamed: IC1.44 (BOOT0), R8.2
NRST: IC1.7 (NRST); also elsewhere on the board
OSC_IN: C26.1, IC1.5 (PF0-OSC_IN), Y1.1 (CRYSTAL_1)
OSC_OUT: IC1.6 (PF1-OSC_OUT), R5.2
PB2: IC1.20 (PB2); also elsewhere on the board
PB10: IC1.21 (PB10); also elsewhere on the board
PB11: IC1.22 (PB11); also elsewhere on the board
PB12: IC1.25 (PB12); also elsewhere on the board
PB15: IC1.28 (PB15); also elsewhere on the board
SPI3_MISO: IC1.40 (PB4), Q1.2 (S), R11.2
SPI3_MOSI: IC1.41 (PB5), Q8.2 (S), R25.2
SPI3_NSS: IC1.38 (PA15), Q6.2 (S), R21.2
SPI3_SCK: IC1.39 (PB3), Q4.2 (S), R17.2
SWCLK: IC1.37 (PA14); also elsewhere on the board
SWDIO: IC1.34 (PA13); also elsewhere on the board
USART3_CTS: FEP_1.P12 (CTS), IC1.26 (PB13)
USART3_RTS: FEP_1.P13 (RTS), IC1.27 (PB14)
USART3_RX: FEP_1.P14 (DATA_RX), IC1.45 (PB8)
USART3_TX: FEP_1.P15 (DATA_TX), IC1.46 (PB9)
USB_DM: IC1.32 (PA11), X9.3
USB_DP: IC1.33 (PA12), X9.2

Notes on the sheet:
VDD-VSS
VDDA-VSSA
Level-Shift
Power Supply
Power Supply Sheme
FEP module
ADC-IC
Controller_Keinz_2023

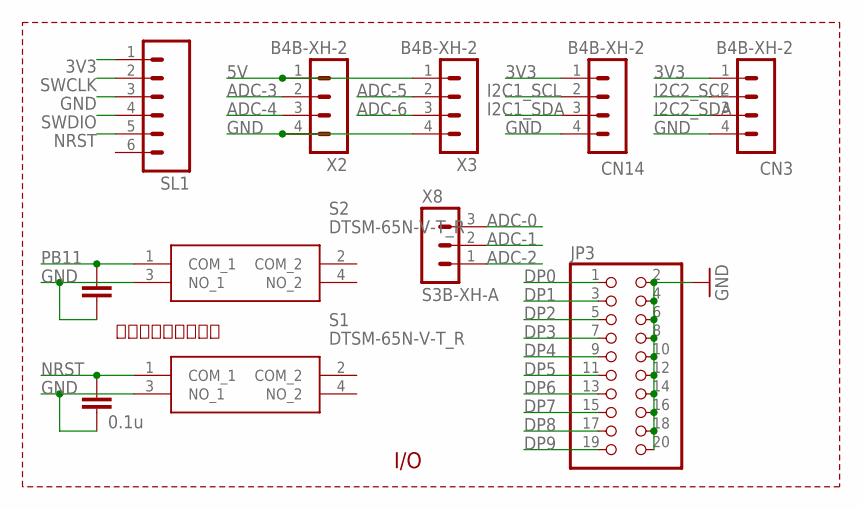
[picture p26: schematic Controller_Keinz_2023.sch, sheet 2]

Parts:
C8, C13: 0.1u; C0603K
CN3, CN14: B4B-XH-2; B4B-XH-A
JP3: PINHD-2X10; 2X10
S1, S2: DTSM-65N-V-T_R; DTSM65NVTR
SL1: MA06; 06PA
X2, X3: B4B-XH-2; B4B-XH-A
X8: S3B-XH-A

Connections:
3V3: CN3.1, CN14.1, SL1.1; also elsewhere on the board
5V: X2.1, X3.1; also elsewhere on the board
ADC-0: X8.3; also elsewhere on the board
ADC-1: X8.2; also elsewhere on the board
ADC-2: X8.1; also elsewhere on the board
ADC-3: X2.2; also elsewhere on the board
ADC-4: X2.3; also elsewhere on the board
ADC-5: X3.2; also elsewhere on the board
ADC-6: X3.3; also elsewhere on the board
DP0: JP3.1; also elsewhere on the board
DP1: JP3.3; also elsewhere on the board
DP2: JP3.5; also elsewhere on the board
DP3: JP3.7; also elsewhere on the board
DP4: JP3.9; also elsewhere on the board
DP5: JP3.11; also elsewhere on the board
DP6: JP3.13; also elsewhere on the board
DP7: JP3.15; also elsewhere on the board
DP8: JP3.17; also elsewhere on the board
DP9: JP3.19; also elsewhere on the board
GND: C8.2, C13.2, CN3.4, CN14.4, JP3.2, JP3.4, JP3.6, JP3.8, JP3.10, JP3.12, JP3.14, JP3.16, JP3.18, JP3.20, S1.3 (NO_1), S2.3 (NO_1), SL1.3, X2.4, X3.4; also elsewhere on the board
I2C1_SCL: CN14.2; also elsewhere on the board
I2C1_SDA: CN14.3; also elsewhere on the board
I2C2_SCL: CN3.2; also elsewhere on the board
I2C2_SDA: CN3.3; also elsewhere on the board
NRST: C13.1, S1.1 (COM_1), SL1.5; also elsewhere on the board
PB11: C8.1, S2.1 (COM_1); also elsewhere on the board
SWCLK: SL1.2; also elsewhere on the board
SWDIO: SL1.4; also elsewhere on the board

Notes on the sheet:
I/O
チャタリング防止用

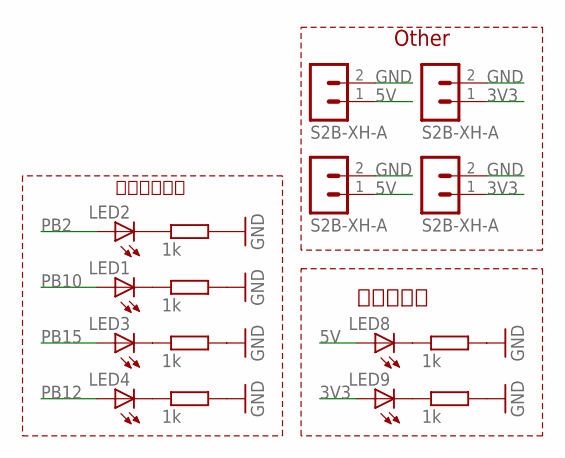
[picture p27: schematic Controller_Keinz_2023.sch, sheet 3]

Parts:
LED1, LED2, LED3, LED4, LED8, LED9: LEDCHIP-LED0805; CHIP-LED0805
R1, R2, R3, R4, R9, R10: 1k; R0603
X4, X5, X6, X7: S2B-XH-A

Connections:
3V3: LED9.A, X4.1, X5.1; also elsewhere on the board
5V: LED8.A, X6.1, X7.1; also elsewhere on the board
GND: R1.2, R2.2, R3.2, R4.2, R9.2, R10.2, X4.2, X5.2, X6.2, X7.2; also elsewhere on the board
unnamed: LED2.C, R1.1
unnamed: LED1.C, R2.1
unnamed: LED3.C, R3.1
unnamed: LED4.C, R4.1
unnamed: LED9.C, R10.1
unnamed: LED8.C, R9.1
PB2: LED2.A; also elsewhere on the board
PB10: LED1.A; also elsewhere on the board
PB12: LED4.A; also elsewhere on the board
PB15: LED3.A; also elsewhere on the board

Notes on the sheet:
インジゲータ
電源確認用
Other

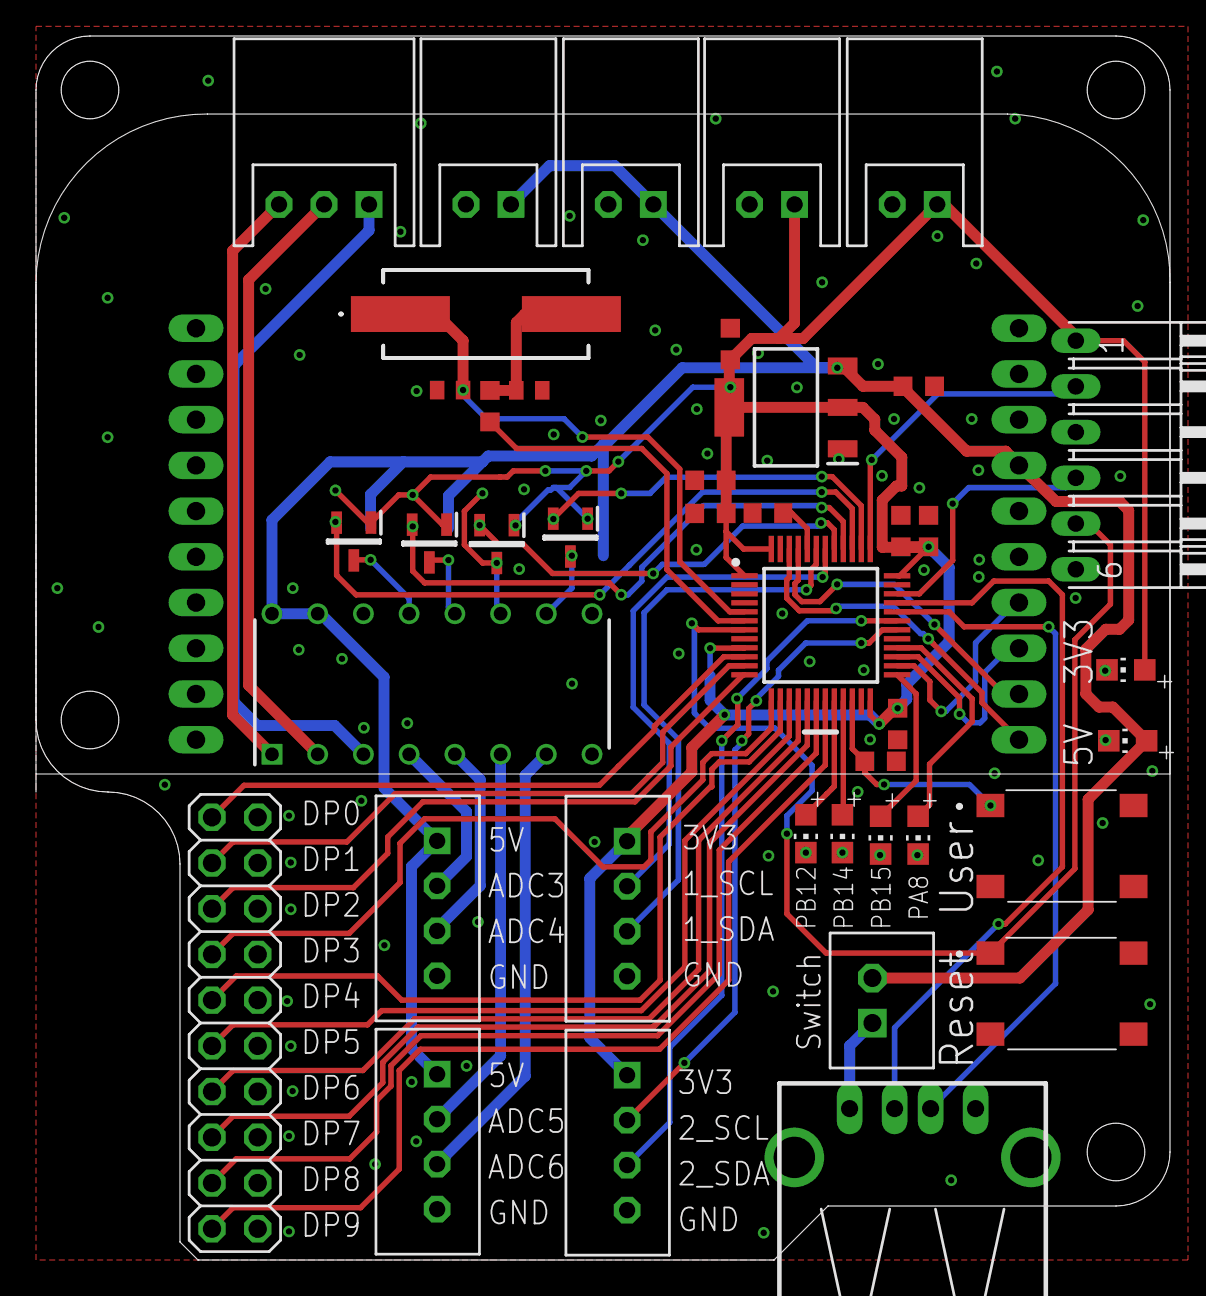
[picture p28: board Controller_Keinz_2023.brd from above]

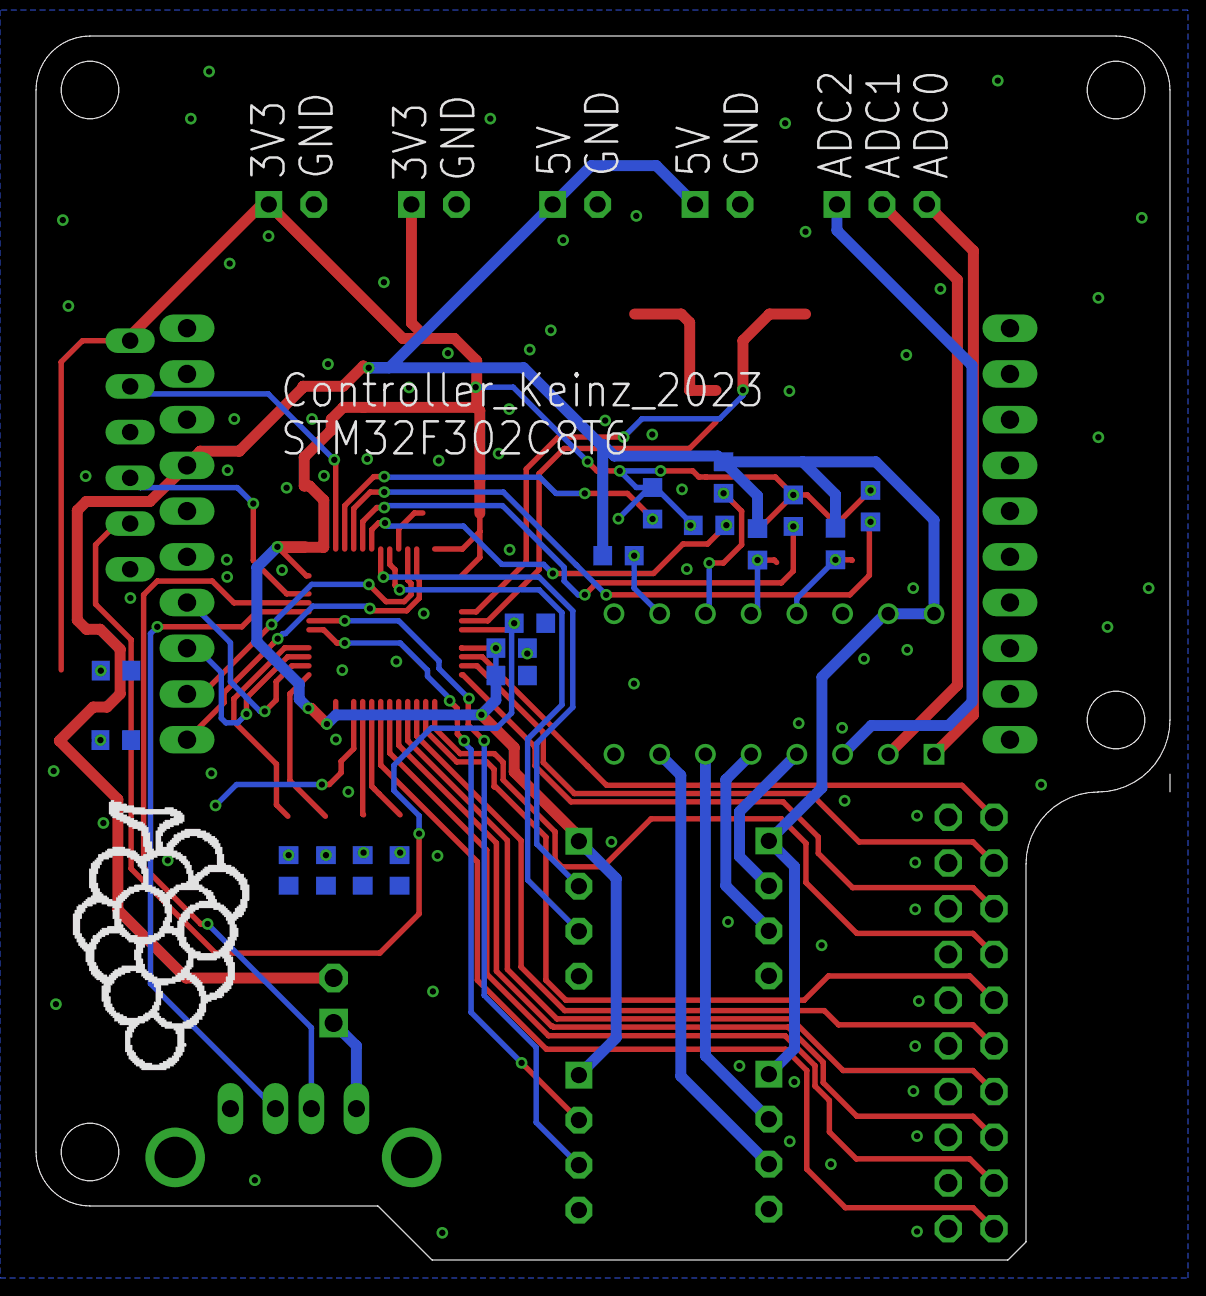
[picture p29: board Controller_Keinz_2023.brd from below]

Board: 2 copper layers, 63.0 x 68.0 mm, 59 parts (17 on the bottom side), 57 nets.
