shinchiryota/Circuit/2022/unitbase_keinz_2022/Unitbase_Keinz_2022.brd

## EAGLE design 2022/unitbase_keinz_2022/Unitbase_Keinz_2022.brd (2024-02-17)

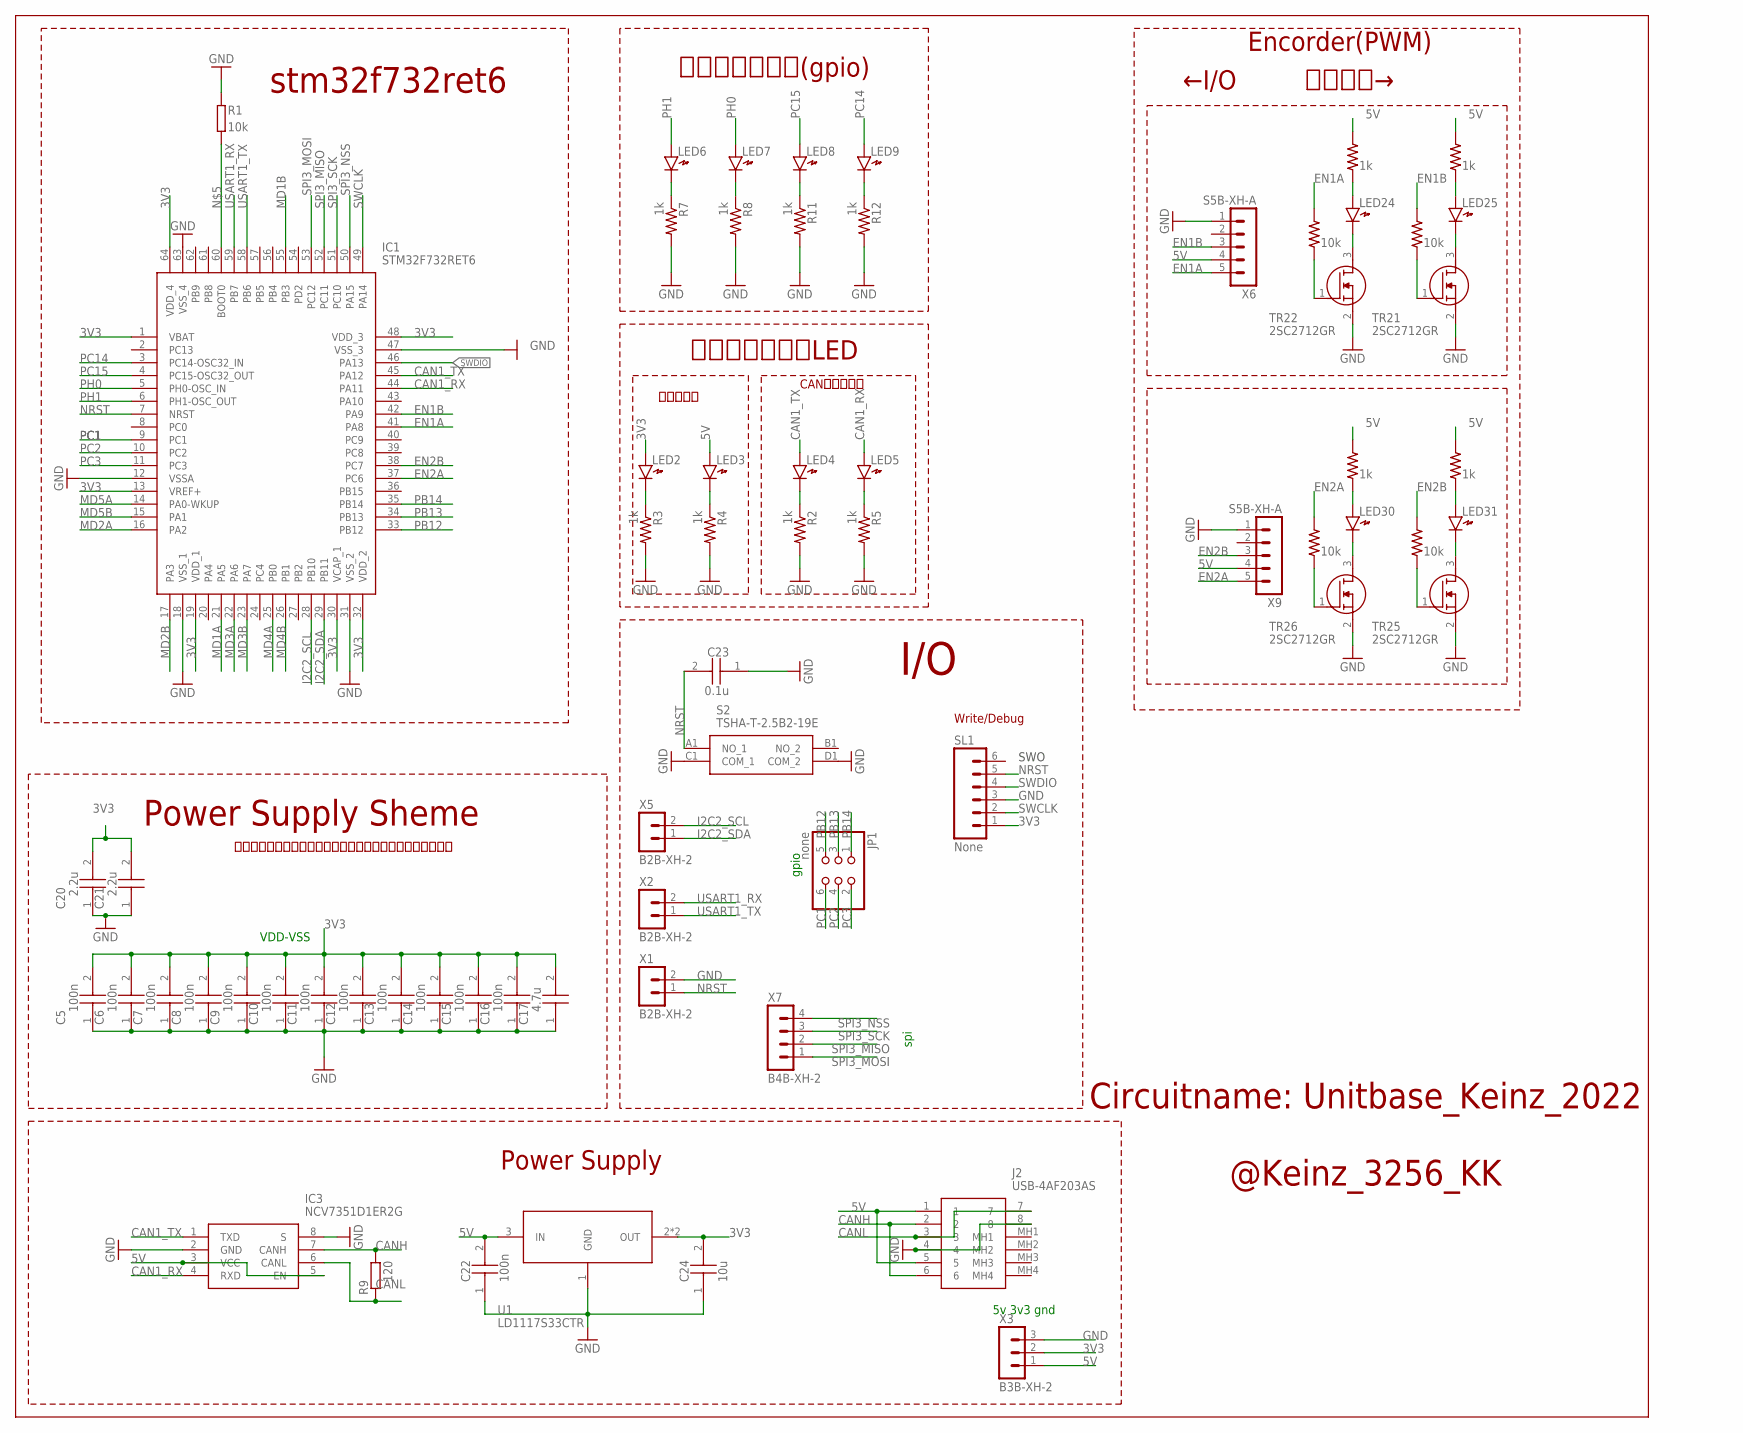
[picture p30: schematic Unitbase_Keinz_2022.sch, sheet 1]

Parts:
C5, C6, C7, C8, C9, C10, C11, C12, C13, C14, C15, C16: 100n; CAPC1709X100N
C17: 4.7u; CAPC1709X100N
C20, C21: 2.2u; CAPC1709X100N
C22: 100n; CAPC1608X90N
C23: 0.1u; CAPC1709X100N
C24: 10u; CAPC1608X90N
IC1: STM32F732RET6; QFP50P1200X1200X160-64N@1
IC3: NCV7351D1ER2G; SOIC127P600X175-8N
J2: USB-4AF203AS; USB4AF203AS
JP1: none; 2X03
LED2, LED3, LED4, LED5, LED6, LED7, LED8, LED9, LED24, LED25, LED30, LED31: LED1608
R1, R54, R60, R66, R68: 10k; SMD1608
R2, R3, R4, R5, R7, R8, R11, R12: 1k; R0603
R9: 120; 1608
R59, R61, R67, R69: 1k; SMD1608
S2: TSHA-T-2.5B2-19E; TSHAT25B219E
SL1: None; 06PA
TR21, TR22, TR25, TR26: 2SC2712GR; SOT-23
U1: LD1117S33CTR; SOT223
X1, X2, X5: B2B-XH-2; B2B-XH-A
X3: B3B-XH-2; B3B-XH-A
X6, X9: S5B-XH-A
X7: B4B-XH-2; B4B-XH-A

Connections:
3V3: C5.2, C6.2, C7.2, C8.2, C9.2, C10.2, C11.2, C12.2, C13.2, C14.2, C15.2, C16.2, C17.2, C20.2, C21.2, C24.2, IC1.1 (VBAT), IC1.13 (VREF+), IC1.19 (VDD_1), IC1.30 (VCAP_1), IC1.32 (VDD_2), IC1.48 (VDD_3), IC1.64 (VDD_4), LED2.A, SL1.1, U1.2 (OUT), U1.4 (OUT), X3.2; also elsewhere on the board
5V: C22.2, IC3.3 (VCC), IC3.5 (EN), J2.1, J2.5, LED3.A, R59.1, R61.1, R67.1, R69.1, U1.3 (IN), X3.1, X6.4, X9.4
CAN1_RX: IC1.44 (PA11), IC3.4 (RXD), LED5.A
CAN1_TX: IC1.45 (PA12), IC3.1 (TXD), LED4.A
CANH: IC3.7 (CANH), J2.2, J2.6, R9.2
CANL: IC3.6 (CANL), J2.3, J2.7, R9.1
EN1A: IC1.41 (PA8), R54.1, X6.5
EN1B: IC1.42 (PA9), R60.1, X6.3
EN2A: IC1.37 (PC6), R66.1, X9.5
EN2B: IC1.38 (PC7), R68.1, X9.3
GND: C5.1, C6.1, C7.1, C8.1, C9.1, C10.1, C11.1, C12.1, C13.1, C14.1, C15.1, C16.1, C17.1, C20.1, C21.1, C22.1, C23.1, C24.1, IC1.12 (VSSA), IC1.18 (VSS_1), IC1.31 (VSS_2), IC1.47 (VSS_3), IC1.63 (VSS_4), IC3.2 (GND), IC3.8 (S), J2.4, J2.8, R1.1, R2.2, R3.2, R4.2, R5.2, R7.2, R8.2, R11.2, R12.2, S2.C1 (COM_1), S2.D1 (COM_2), SL1.3, TR21.2 (S), TR22.2 (S), TR25.2 (S), TR26.2 (S), U1.1 (GND), X1.2, X3.3, X6.1, X9.1; also elsewhere on the board
I2C2_SCL: IC1.28 (PB10), X5.2
I2C2_SDA: IC1.29 (PB11), X5.1
MD1A: IC1.21 (PA5); also elsewhere on the board
MD1B: IC1.55 (PB3); also elsewhere on the board
MD2A: IC1.16 (PA2); also elsewhere on the board
MD2B: IC1.17 (PA3); also elsewhere on the board
MD3A: IC1.22 (PA6); also elsewhere on the board
MD3B: IC1.23 (PA7); also elsewhere on the board
MD4A: IC1.25 (PB0); also elsewhere on the board
MD4B: IC1.26 (PB1); also elsewhere on the board
MD5A: IC1.14 (PA0-WKUP); also elsewhere on the board
MD5B: IC1.15 (PA1); also elsewhere on the board
unnamed: LED7.K, R8.1
unnamed: IC1.60 (BOOT0), R1.2
unnamed: LED2.K, R3.1
unnamed: LED3.K, R4.1
unnamed: LED5.K, R5.1
unnamed: LED4.K, R2.1
unnamed: R54.2, TR22.1 (G)
unnamed: LED24.K, TR22.3 (D)
unnamed: LED6.K, R7.1
unnamed: LED9.K, R12.1
unnamed: LED24.A, R59.2
unnamed: LED8.K, R11.1
unnamed: R60.2, TR21.1 (G)
unnamed: LED25.K, TR21.3 (D)
unnamed: LED25.A, R61.2
unnamed: R66.2, TR26.1 (G)
unnamed: LED30.K, TR26.3 (D)
unnamed: LED30.A, R67.2
unnamed: R68.2, TR25.1 (G)
unnamed: LED31.K, TR25.3 (D)
unnamed: LED31.A, R69.2
NRST: C23.2, IC1.7 (NRST), S2.A1 (NO_1), SL1.5, X1.1
PB12: IC1.33 (PB12), JP1.5
PB13: IC1.34 (PB13), JP1.3
PB14: IC1.35 (PB14), JP1.1
PC1: IC1.9 (PC1), JP1.6
PC2: IC1.10 (PC2), JP1.4
PC3: IC1.11 (PC3), JP1.2
PC14: IC1.3 (PC14-OSC32_IN), LED9.A
PC15: IC1.4 (PC15-OSC32_OUT), LED8.A
PH0: IC1.5 (PH0-OSC_IN), LED7.A
PH1: IC1.6 (PH1-OSC_OUT), LED6.A
SPI3_MISO: IC1.52 (PC11), X7.2
SPI3_MOSI: IC1.53 (PC12), X7.1
SPI3_NSS: IC1.50 (PA15), X7.4
SPI3_SCK: IC1.51 (PC10), X7.3
SWCLK: IC1.49 (PA14), SL1.2
SWDIO: IC1.46 (PA13), SL1.4
USART1_RX: IC1.59 (PB7), X2.2
USART1_TX: IC1.58 (PB6), X2.1

Notes on the sheet:
gpio
インジゲータ用(gpio)
VDD-VSS
Power Supply Sheme
stm32f732ret6
Write/Debug
spi
5v 3v3 gnd
電源確認用
CAN通信確認用
インジゲータ用LED
I/O
Power Supply
Encorder(PWM)
←I/O 電流増幅→
Circuitname: Unitbase_Keinz_2022 @Keinz_3256_KK
SWO
電源様式はマイコンの破壊防止のために実装する物である。
