shinchiryota/Circuit/2022/unitbase_keinz_2022/Unitbase_Keinz_2022.brd

## EAGLE design 2022/unitbase_keinz_2022/Unitbase_Keinz_2022.brd (continued)

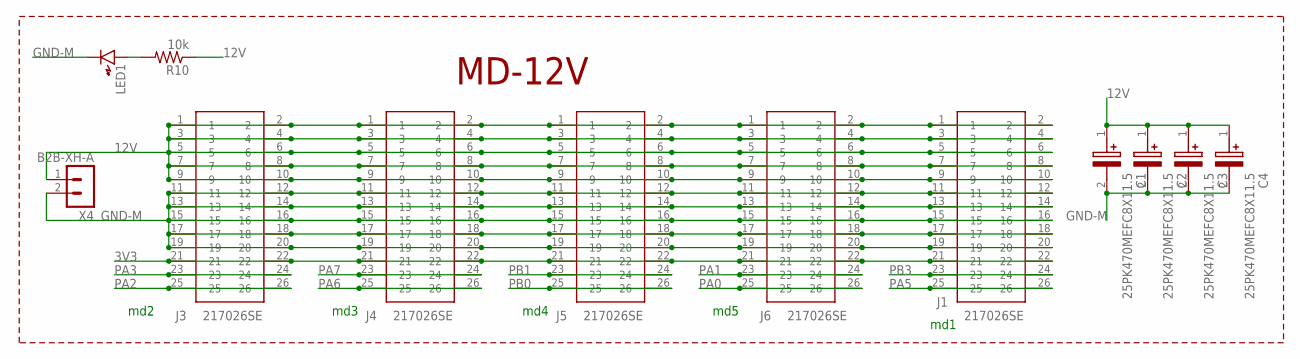
[picture p31: schematic Unitbase_Keinz_2022.sch, sheet 2, <H2>12V</H2>]

Parts:
C1, C2, C3, C4: 25PK470MEFC8X11.5; CAPPRD350W60D825H1150
J1, J3, J4, J5, J6: 217026SE
LED1: LED1608
R10: 10k; R0603
X4: B2B-XH-A

Connections:
3V3: J1.21, J1.22, J3.21, J3.22, J4.21, J4.22, J5.21, J5.22, J6.21, J6.22; also elsewhere on the board
12V: C1.1 (+), C2.1 (+), C3.1 (+), C4.1 (+), J1.1, J1.2, J1.3, J1.4, J1.5, J1.6, J1.7, J1.8, J1.9, J1.10, J3.1, J3.2, J3.3, J3.4, J3.5, J3.6, J3.7, J3.8, J3.9, J3.10, J4.1, J4.2, J4.3, J4.4, J4.5, J4.6, J4.7, J4.8, J4.9, J4.10, J5.1, J5.2, J5.3, J5.4, J5.5, J5.6, J5.7, J5.8, J5.9, J5.10, J6.1, J6.2, J6.3, J6.4, J6.5, J6.6, J6.7, J6.8, J6.9, J6.10, R10.1, X4.1
GND-M: C1.2 (-), C2.2 (-), C3.2 (-), C4.2 (-), J1.11, J1.12, J1.13, J1.14, J1.15, J1.16, J1.17, J1.18, J1.19, J1.20, J3.11, J3.12, J3.13, J3.14, J3.15, J3.16, J3.17, J3.18, J3.19, J3.20, J4.11, J4.12, J4.13, J4.14, J4.15, J4.16, J4.17, J4.18, J4.19, J4.20, J5.11, J5.12, J5.13, J5.14, J5.15, J5.16, J5.17, J5.18, J5.19, J5.20, J6.11, J6.12, J6.13, J6.14, J6.15, J6.16, J6.17, J6.18, J6.19, J6.20, LED1.K, X4.2
unnamed: LED1.A, R10.2
PA0: J6.25, J6.26; also elsewhere on the board
PA1: J6.23, J6.24; also elsewhere on the board
PA2: J3.25, J3.26; also elsewhere on the board
PA3: J3.23, J3.24; also elsewhere on the board
PA5: J1.25, J1.26; also elsewhere on the board
PA6: J4.25, J4.26; also elsewhere on the board
PA7: J4.23, J4.24; also elsewhere on the board
PB0: J5.25, J5.26; also elsewhere on the board
PB1: J5.23, J5.24; also elsewhere on the board
PB3: J1.23, J1.24; also elsewhere on the board

Notes on the sheet:
MD-12V
md1
md2
md3
md4
md5

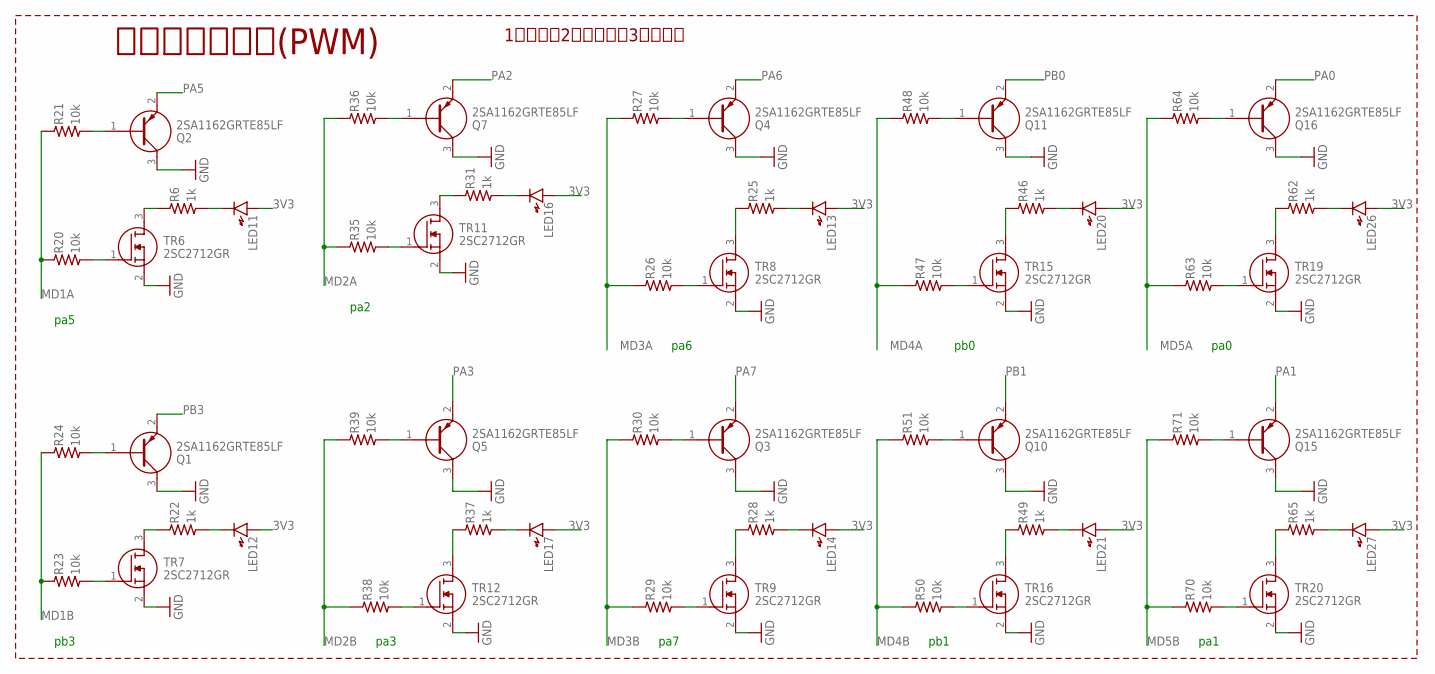
[picture p32: schematic Unitbase_Keinz_2022.sch, sheet 3, 電流増幅]

Parts:
LED11, LED12, LED13, LED14, LED16, LED17, LED20, LED21, LED26, LED27: LED1608
Q1, Q2, Q3, Q4, Q5, Q7, Q10, Q11, Q15, Q16: 2SA1162GRTE85LF
R6, R22, R25, R28, R31, R37, R46, R49, R62, R65: 1k; SMD1608
R20, R21, R23, R24, R26, R27, R29, R30, R35, R36, R38, R39, R47, R48, R50, R51, R63, R64, R70, R71: 10k; SMD1608
TR6, TR7, TR8, TR9, TR11, TR12, TR15, TR16, TR19, TR20: 2SC2712GR; SOT-23

Connections:
3V3: LED11.A, LED12.A, LED13.A, LED14.A, LED16.A, LED17.A, LED20.A, LED21.A, LED26.A, LED27.A; also elsewhere on the board
GND: Q1.3 (C), Q2.3 (C), Q3.3 (C), Q4.3 (C), Q5.3 (C), Q7.3 (C), Q10.3 (C), Q11.3 (C), Q15.3 (C), Q16.3 (C), TR6.2 (S), TR7.2 (S), TR8.2 (S), TR9.2 (S), TR11.2 (S), TR12.2 (S), TR15.2 (S), TR16.2 (S), TR19.2 (S), TR20.2 (S); also elsewhere on the board
MD1A: R20.1, R21.1; also elsewhere on the board
MD1B: R23.1, R24.1; also elsewhere on the board
MD2A: R35.1, R36.1; also elsewhere on the board
MD2B: R38.1, R39.1; also elsewhere on the board
MD3A: R26.1, R27.1; also elsewhere on the board
MD3B: R29.1, R30.1; also elsewhere on the board
MD4A: R47.1, R48.1; also elsewhere on the board
MD4B: R50.1, R51.1; also elsewhere on the board
MD5A: R63.1, R64.1; also elsewhere on the board
MD5B: R70.1, R71.1; also elsewhere on the board
unnamed: R6.1, TR6.3 (D)
unnamed: R20.2, TR6.1 (G)
unnamed: LED11.K, R6.2
unnamed: R22.1, TR7.3 (D)
unnamed: R23.2, TR7.1 (G)
unnamed: LED12.K, R22.2
unnamed: Q1.1 (B), R24.2
unnamed: Q2.1 (B), R21.2
unnamed: R25.1, TR8.3 (D)
unnamed: R26.2, TR8.1 (G)
unnamed: LED13.K, R25.2
unnamed: R28.1, TR9.3 (D)
unnamed: R29.2, TR9.1 (G)
unnamed: LED14.K, R28.2
unnamed: Q3.1 (B), R30.2
unnamed: Q4.1 (B), R27.2
unnamed: R31.1, TR11.3 (D)
unnamed: R35.2, TR11.1 (G)
unnamed: LED16.K, R31.2
unnamed: R37.1, TR12.3 (D)
unnamed: R38.2, TR12.1 (G)
unnamed: LED17.K, R37.2
unnamed: Q5.1 (B), R39.2
unnamed: Q7.1 (B), R36.2
unnamed: R46.1, TR15.3 (D)
unnamed: R47.2, TR15.1 (G)
unnamed: LED20.K, R46.2
unnamed: R49.1, TR16.3 (D)
unnamed: R50.2, TR16.1 (G)
unnamed: LED21.K, R49.2
unnamed: Q10.1 (B), R51.2
unnamed: Q11.1 (B), R48.2
unnamed: R62.1, TR19.3 (D)
unnamed: R63.2, TR19.1 (G)
unnamed: LED26.K, R62.2
unnamed: R65.1, TR20.3 (D)
unnamed: R70.2, TR20.1 (G)
unnamed: LED27.K, R65.2
unnamed: Q15.1 (B), R71.2
unnamed: Q16.1 (B), R64.2
PA0: Q16.2 (E); also elsewhere on the board
PA1: Q15.2 (E); also elsewhere on the board
PA2: Q7.2 (E); also elsewhere on the board
PA3: Q5.2 (E); also elsewhere on the board
PA5: Q2.2 (E); also elsewhere on the board
PA6: Q4.2 (E); also elsewhere on the board
PA7: Q3.2 (E); also elsewhere on the board
PB0: Q11.2 (E); also elsewhere on the board
PB1: Q10.2 (E); also elsewhere on the board
PB3: Q1.2 (E); also elsewhere on the board

Notes on the sheet:
電流増幅用回路(PWM)
1ベース、2コレクタ、3エミッタ
pa5
pb3
pa2
pa3
pa6
pa7
pb0
pb1
pa0
pa1

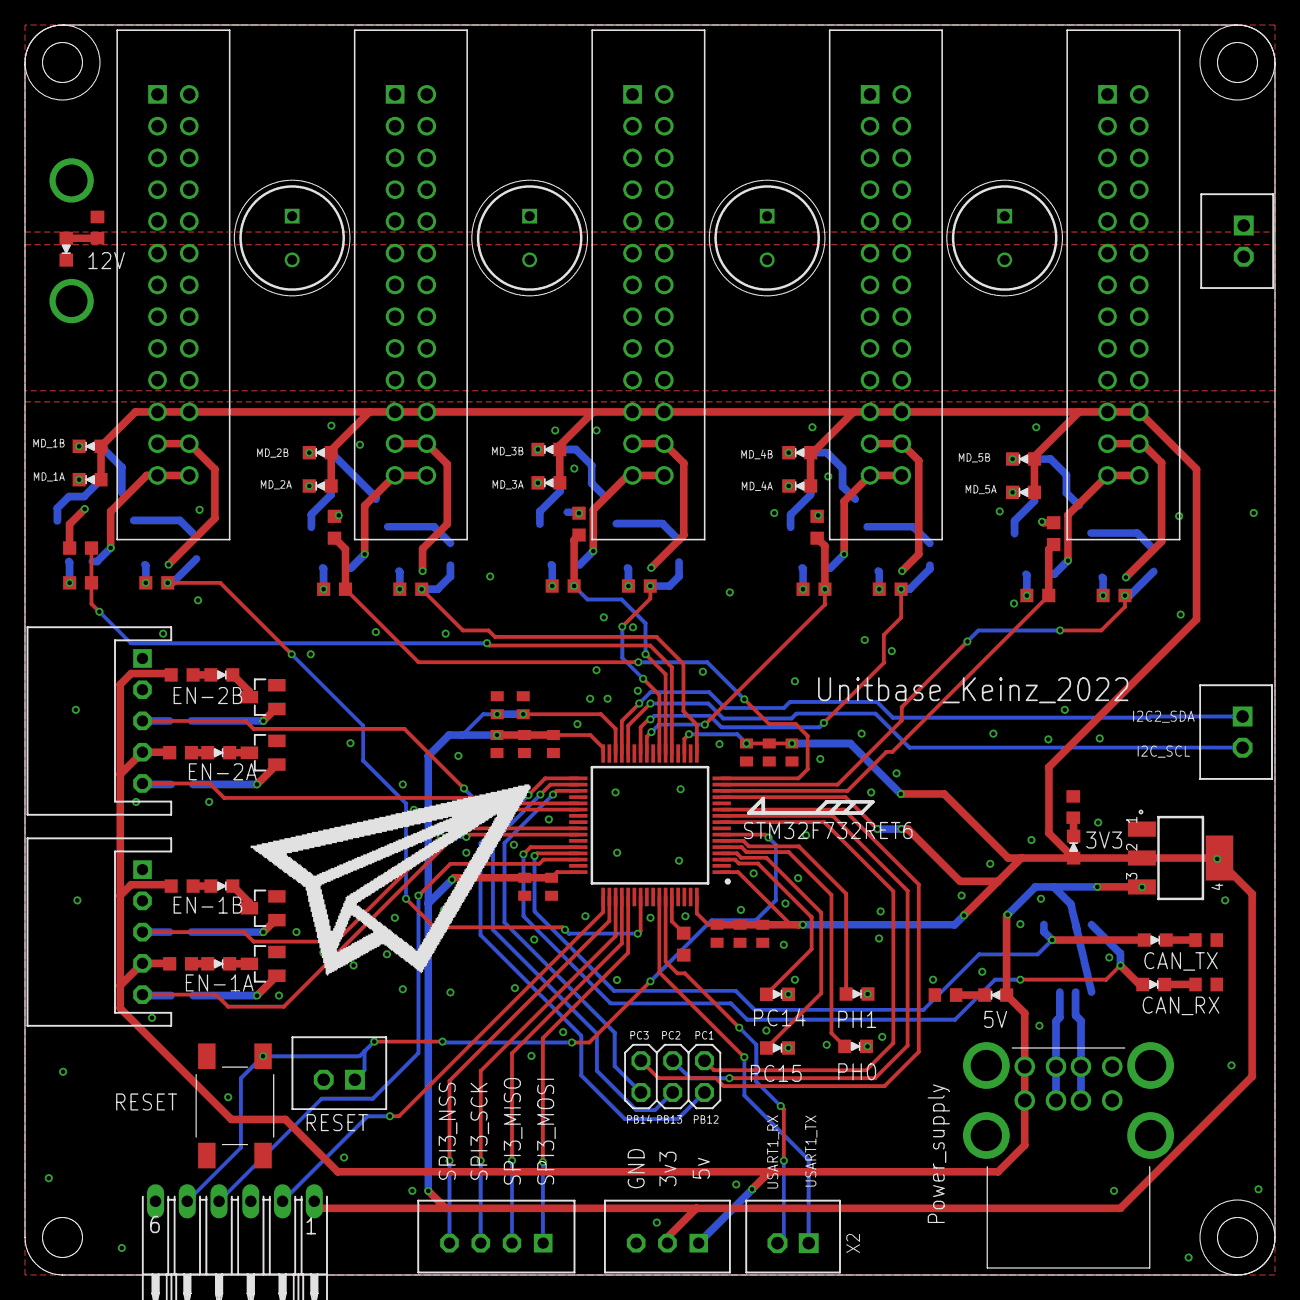
[picture p33: board Unitbase_Keinz_2022.brd from above]

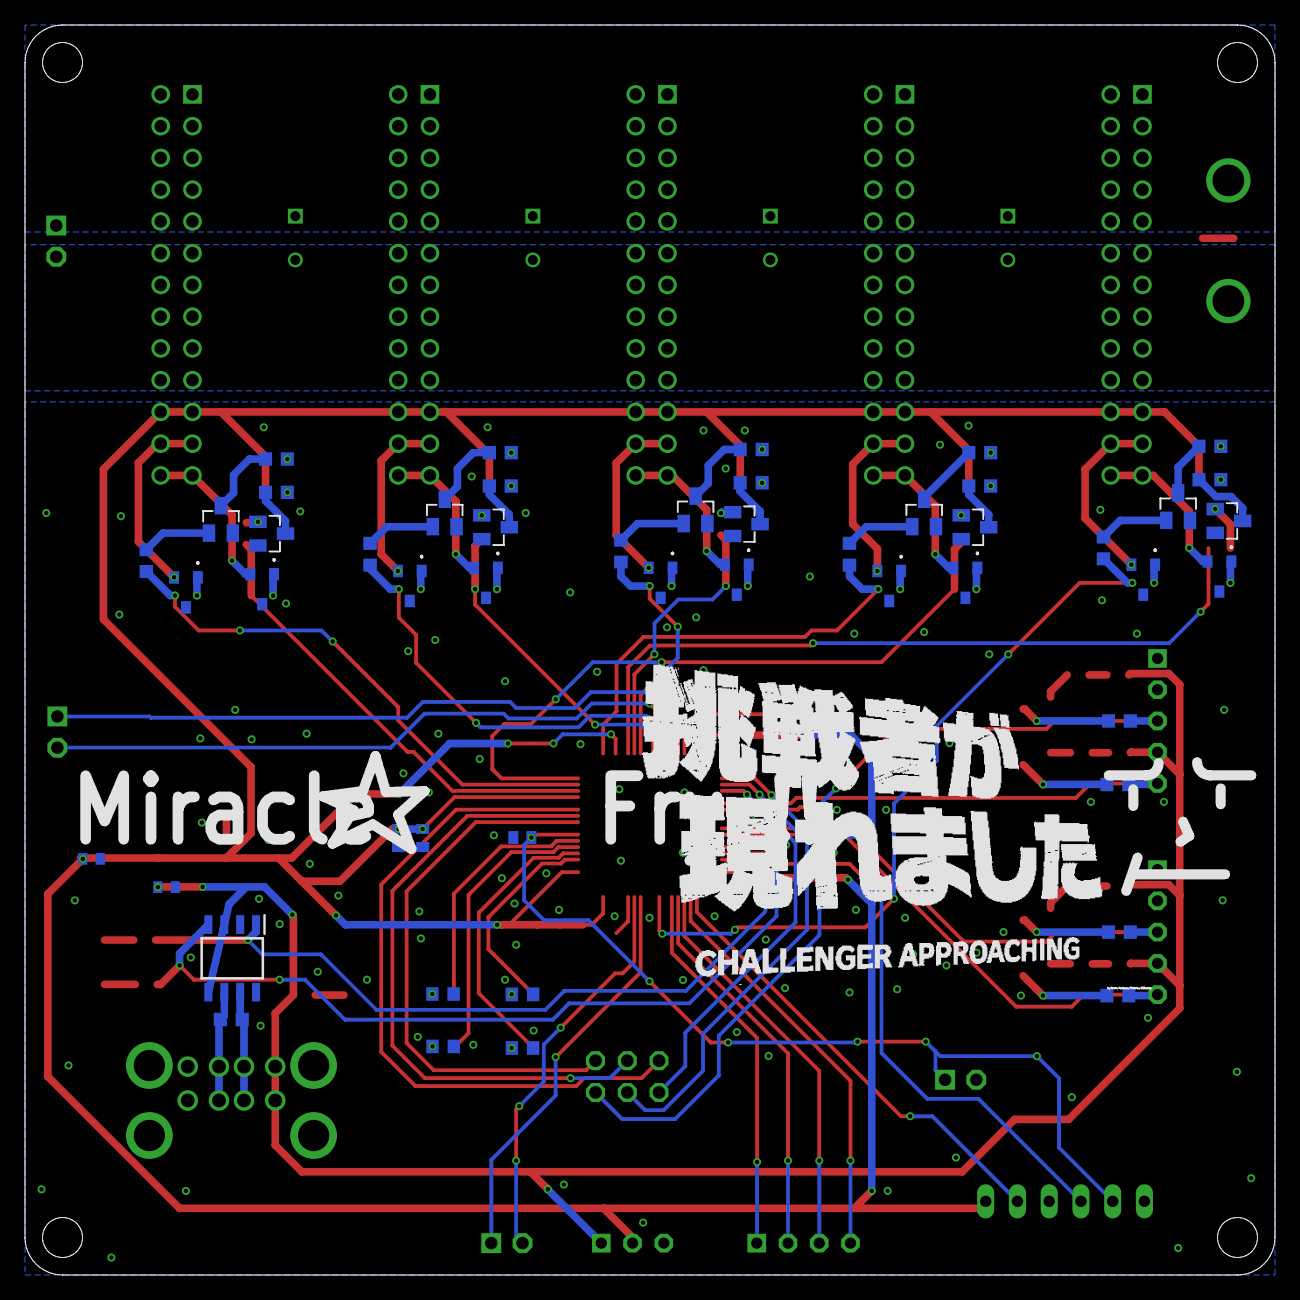
[picture p34: board Unitbase_Keinz_2022.brd from below]

Board: 2 copper layers, 100.0 x 100.0 mm, 138 parts (50 on the bottom side), 116 nets.
