shinchiryota/Circuit/2022/servo_solenoidvalve_of_Tatebayashi/Servosolenoidvalve_of_Tatebayashi.brd

## EAGLE design 2022/servo_solenoidvalve_of_Tatebayashi/Servosolenoidvalve_of_Tatebayashi.brd (2024-02-17)

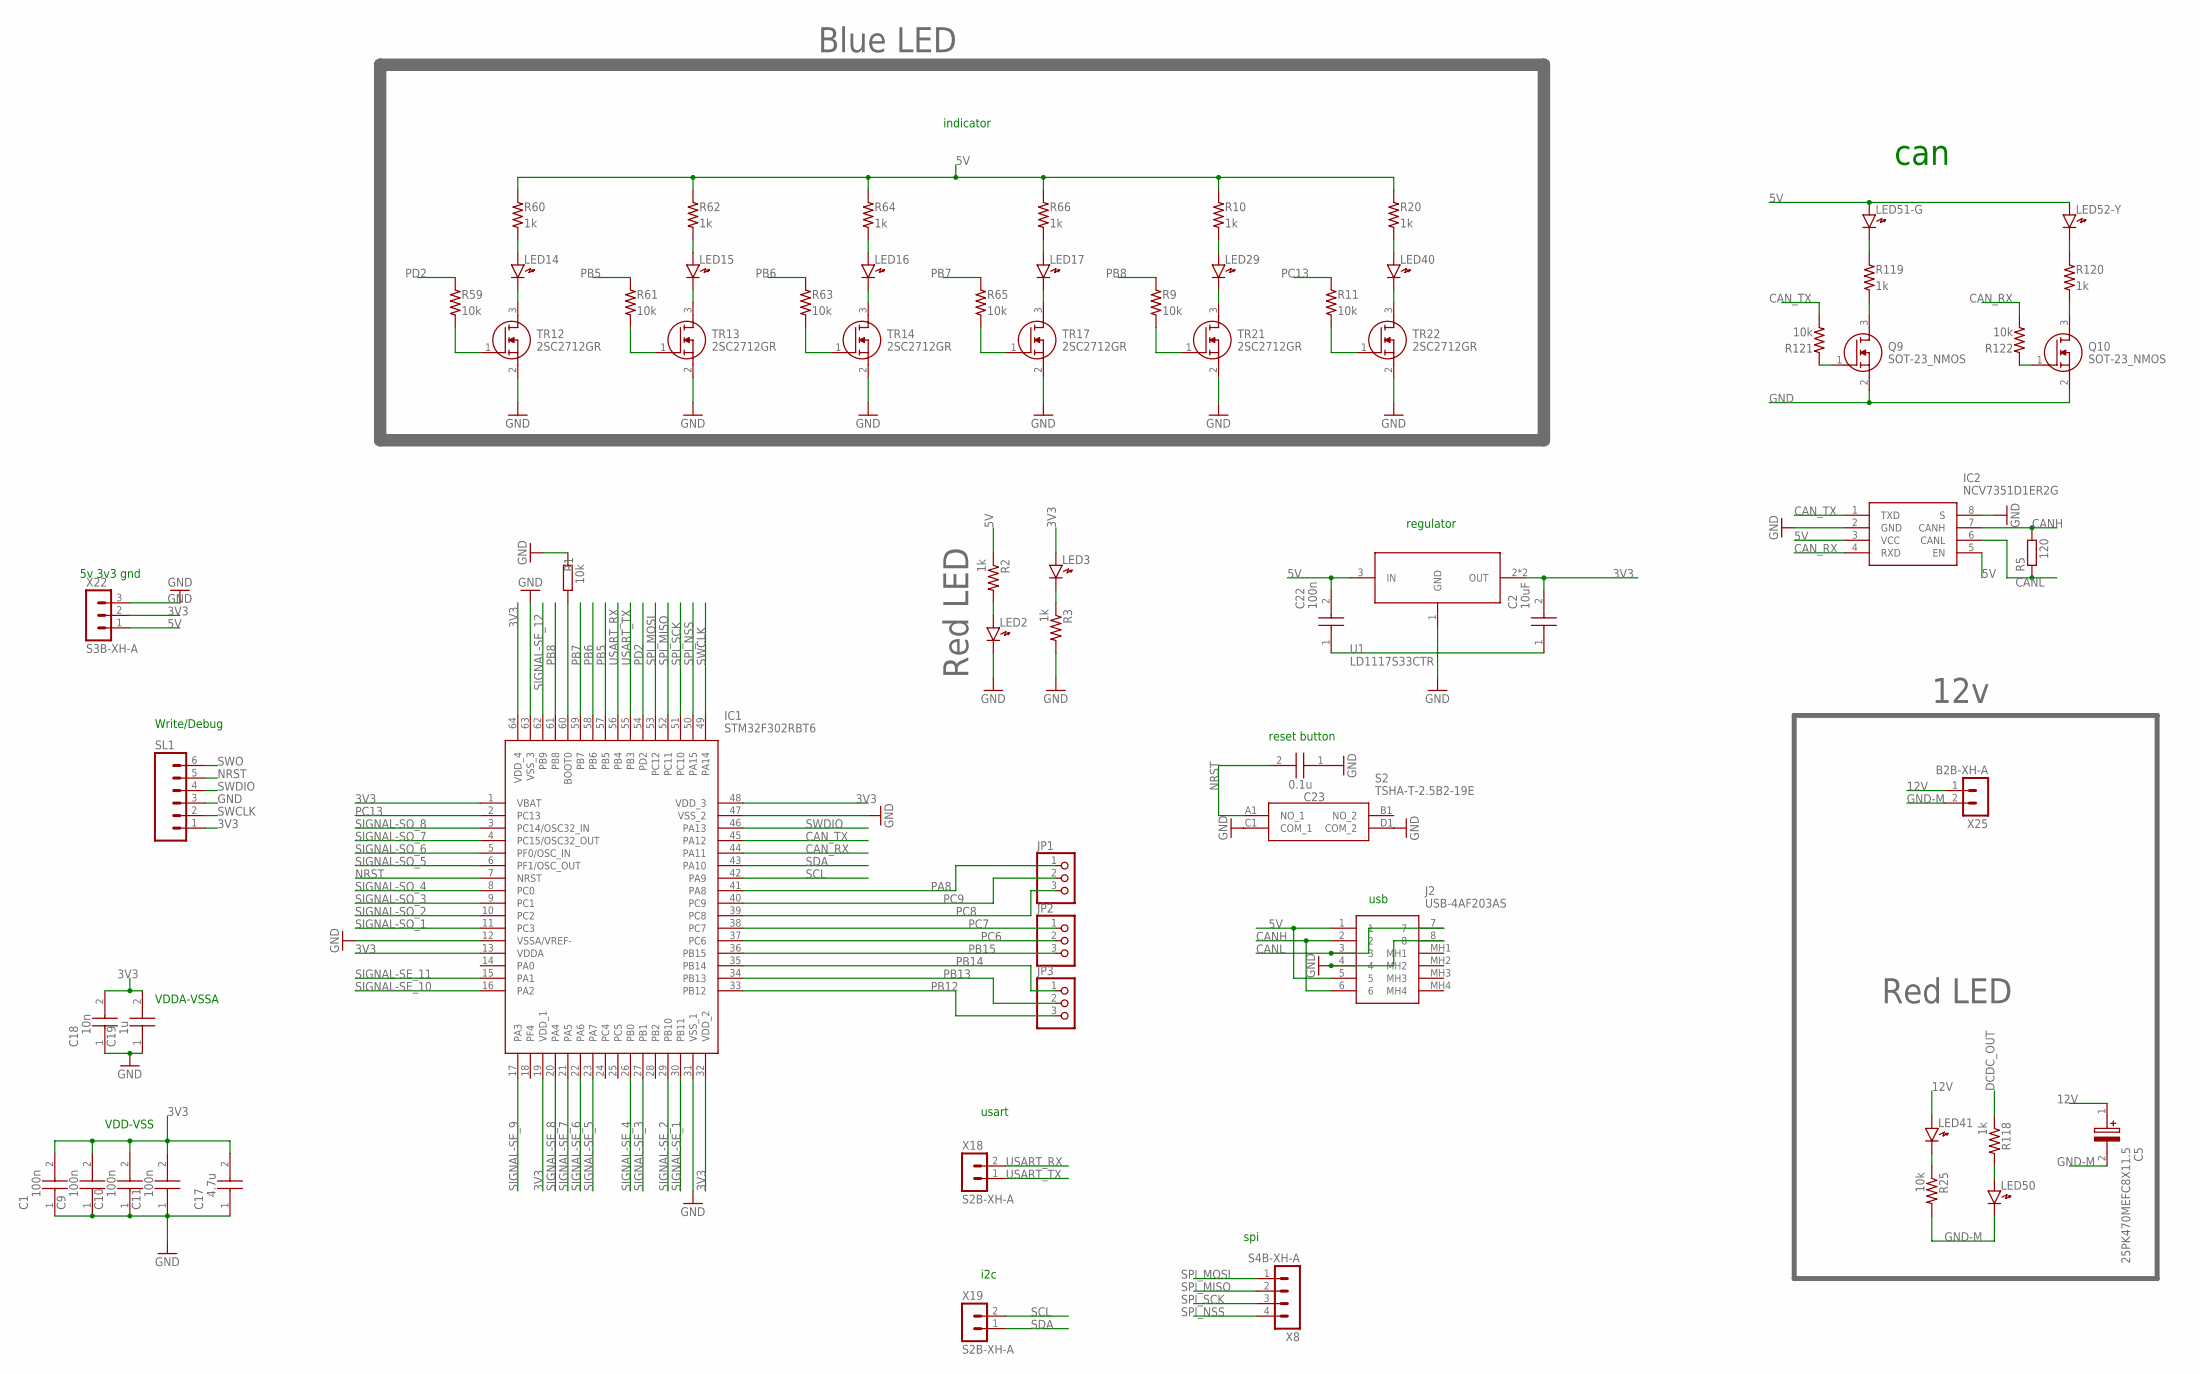
[picture p35: schematic Servosolenoidvalve_of_Tatebayashi.sch, sheet 1]

Parts:
C1, C9, C10, C11: 100n; CAPC1709X100N
C2: 10uF; CAPC1608X90N
C5: 25PK470MEFC8X11.5; CAPPRD350W60D825H1150
C17: 4.7u; CAPC1709X100N
C18: 10n; CAPC1709X100N
C19: 1u; CAPC1709X100N
C22: 100n; CAPC1608X90N
C23: 0.1u; CAPC1709X100N
IC1: STM32F302RBT6; QFP50P1200X1200X160-64N
IC2: NCV7351D1ER2G; SOIC127P600X175-8N
J2: USB-4AF203AS; USB4AF203AS
JP1, JP2, JP3: PINHD-1X3; 1X03
LED2, LED3, LED14, LED15, LED16, LED17, LED29, LED40, LED41, LED50, LED51-G, LED52-Y: LED1608
Q9, Q10: SOT-23_NMOS; SOT-23
R1: 10k; 1608
R2, R3, R118: 1k; R0603
R5: 120; R0805
R9, R11, R59, R61, R63, R65, R121, R122: 10k; SMD1608
R10, R20, R60, R62, R64, R66, R119, R120: 1k; SMD1608
R25: 10k; R0603
S2: TSHA-T-2.5B2-19E; TSHAT25B219E
SL1: MA06; 06PA
TR12, TR13, TR14, TR17, TR21, TR22: 2SC2712GR; SOT-23
U1: LD1117S33CTR; SOT223
X8: S4B-XH-A
X18, X19: S2B-XH-A
X22: S3B-XH-A
X25: B2B-XH-A

Connections:
3V3: C1.2, C2.2, C9.2, C10.2, C11.2, C17.2, C18.2, C19.2, IC1.1 (VBAT), IC1.13 (VDDA), IC1.19 (VDD_1), IC1.32 (VDD_2), IC1.48 (VDD_3), IC1.64 (VDD_4), LED3.A, SL1.1, U1.2 (OUT), U1.4 (OUT), X22.2; also elsewhere on the board
5V: C22.2, IC2.3 (VCC), IC2.5 (EN), J2.1, J2.5, LED51-G.A, LED52-Y.A, R2.1, R10.1, R20.1, R60.1, R62.1, R64.1, R66.1, U1.3 (IN), X22.1
12V: C5.1 (+), LED41.A, X25.1; also elsewhere on the board
CANH: IC2.7 (CANH), J2.2, J2.6, R5.2
CANL: IC2.6 (CANL), J2.3, J2.7, R5.1
CAN_RX: IC1.44 (PA11), IC2.4 (RXD), R122.2
CAN_TX: IC1.45 (PA12), IC2.1 (TXD), R121.2
DCDC_OUT: R118.1; also elsewhere on the board
GND: C1.1, C2.1, C9.1, C10.1, C11.1, C17.1, C18.1, C19.1, C22.1, C23.1, IC1.12 (VSSA/VREF-), IC1.31 (VSS_1), IC1.47 (VSS_2), IC1.63 (VSS_3), IC2.2 (GND), IC2.8 (S), J2.4, J2.8, LED2.K, Q9.2 (S), Q10.2 (S), R1.2, R3.2, S2.C1 (COM_1), S2.D1 (COM_2), SL1.3, TR12.2 (S), TR13.2 (S), TR14.2 (S), TR17.2 (S), TR21.2 (S), TR22.2 (S), U1.1 (GND), X22.3; also elsewhere on the board
GND-M: C5.2 (-), LED50.K, R25.2, X25.2; also elsewhere on the board
unnamed: LED2.A, R2.2
unnamed: LED3.K, R3.1
unnamed: IC1.60 (BOOT0), R1.1
unnamed: R59.2, TR12.1 (G)
unnamed: LED14.K, TR12.3 (D)
unnamed: LED14.A, R60.2
unnamed: R61.2, TR13.1 (G)
unnamed: LED15.K, TR13.3 (D)
unnamed: LED15.A, R62.2
unnamed: R63.2, TR14.1 (G)
unnamed: LED16.K, TR14.3 (D)
unnamed: LED16.A, R64.2
unnamed: R65.2, TR17.1 (G)
unnamed: LED17.K, TR17.3 (D)
unnamed: LED17.A, R66.2
unnamed: R9.2, TR21.1 (G)
unnamed: LED29.K, TR21.3 (D)
unnamed: LED29.A, R10.2
unnamed: R11.2, TR22.1 (G)
unnamed: LED40.K, TR22.3 (D)
unnamed: LED40.A, R20.2
unnamed: LED41.K, R25.1
unnamed: Q9.1 (G), R121.1
unnamed: Q10.1 (G), R122.1
unnamed: LED51-G.K, R119.1
unnamed: LED52-Y.K, R120.1
unnamed: LED50.A, R118.2
unnamed: Q9.3 (D), R119.2
unnamed: Q10.3 (D), R120.2
NRST: C23.2, IC1.7 (NRST), S2.A1 (NO_1), SL1.5
PA8: IC1.41 (PA8), JP1.1
PB5: IC1.57 (PB5), R61.1
PB6: IC1.58 (PB6), R63.1
PB7: IC1.59 (PB7), R65.1
PB8: IC1.61 (PB8), R9.1
PB12: IC1.33 (PB12), JP3.3
PB13: IC1.34 (PB13), JP3.2
PB14: IC1.35 (PB14), JP3.1
PB15: IC1.36 (PB15), JP2.3
PC6: IC1.37 (PC6), JP2.2
PC7: IC1.38 (PC7), JP2.1
PC8: IC1.39 (PC8), JP1.3
PC9: IC1.40 (PC9), JP1.2
PC13: IC1.2 (PC13), R11.1
PD2: IC1.54 (PD2), R59.1
SCL: IC1.42 (PA9), X19.2
SDA: IC1.43 (PA10), X19.1
SIGNAL-SE_1: IC1.30 (PB11); also elsewhere on the board
SIGNAL-SE_2: IC1.29 (PB10); also elsewhere on the board
SIGNAL-SE_3: IC1.27 (PB1); also elsewhere on the board
SIGNAL-SE_4: IC1.26 (PB0); also elsewhere on the board
SIGNAL-SE_5: IC1.23 (PA7); also elsewhere on the board
SIGNAL-SE_6: IC1.22 (PA6); also elsewhere on the board
SIGNAL-SE_7: IC1.21 (PA5); also elsewhere on the board
SIGNAL-SE_8: IC1.20 (PA4); also elsewhere on the board
SIGNAL-SE_9: IC1.17 (PA3); also elsewhere on the board
SIGNAL-SE_10: IC1.16 (PA2); also elsewhere on the board
SIGNAL-SE_11: IC1.15 (PA1); also elsewhere on the board
SIGNAL-SE_12: IC1.62 (PB9); also elsewhere on the board
SIGNAL-SO_1: IC1.11 (PC3); also elsewhere on the board
SIGNAL-SO_2: IC1.10 (PC2); also elsewhere on the board
SIGNAL-SO_3: IC1.9 (PC1); also elsewhere on the board
SIGNAL-SO_4: IC1.8 (PC0); also elsewhere on the board
SIGNAL-SO_5: IC1.6 (PF1/OSC_OUT); also elsewhere on the board
SIGNAL-SO_6: IC1.5 (PF0/OSC_IN); also elsewhere on the board
SIGNAL-SO_7: IC1.4 (PC15/OSC32_OUT); also elsewhere on the board
SIGNAL-SO_8: IC1.3 (PC14/OSC32_IN); also elsewhere on the board
SPI_MISO: IC1.52 (PC11), X8.2
SPI_MOSI: IC1.53 (PC12), X8.1
SPI_NSS: IC1.50 (PA15), X8.4
SPI_SCK: IC1.51 (PC10), X8.3
SWCLK: IC1.49 (PA14), SL1.2
SWDIO: IC1.46 (PA13), SL1.4
SWO: SL1.6
USART_RX: IC1.56 (PB4), X18.2
USART_TX: IC1.55 (PB3), X18.1

Notes on the sheet:
Write/Debug
indicator
spi
VDD-VSS
VDDA-VSSA
5v 3v3 gnd
regulator
reset button
usb
usart
i2c
can
12v
Blue LED
Red LED

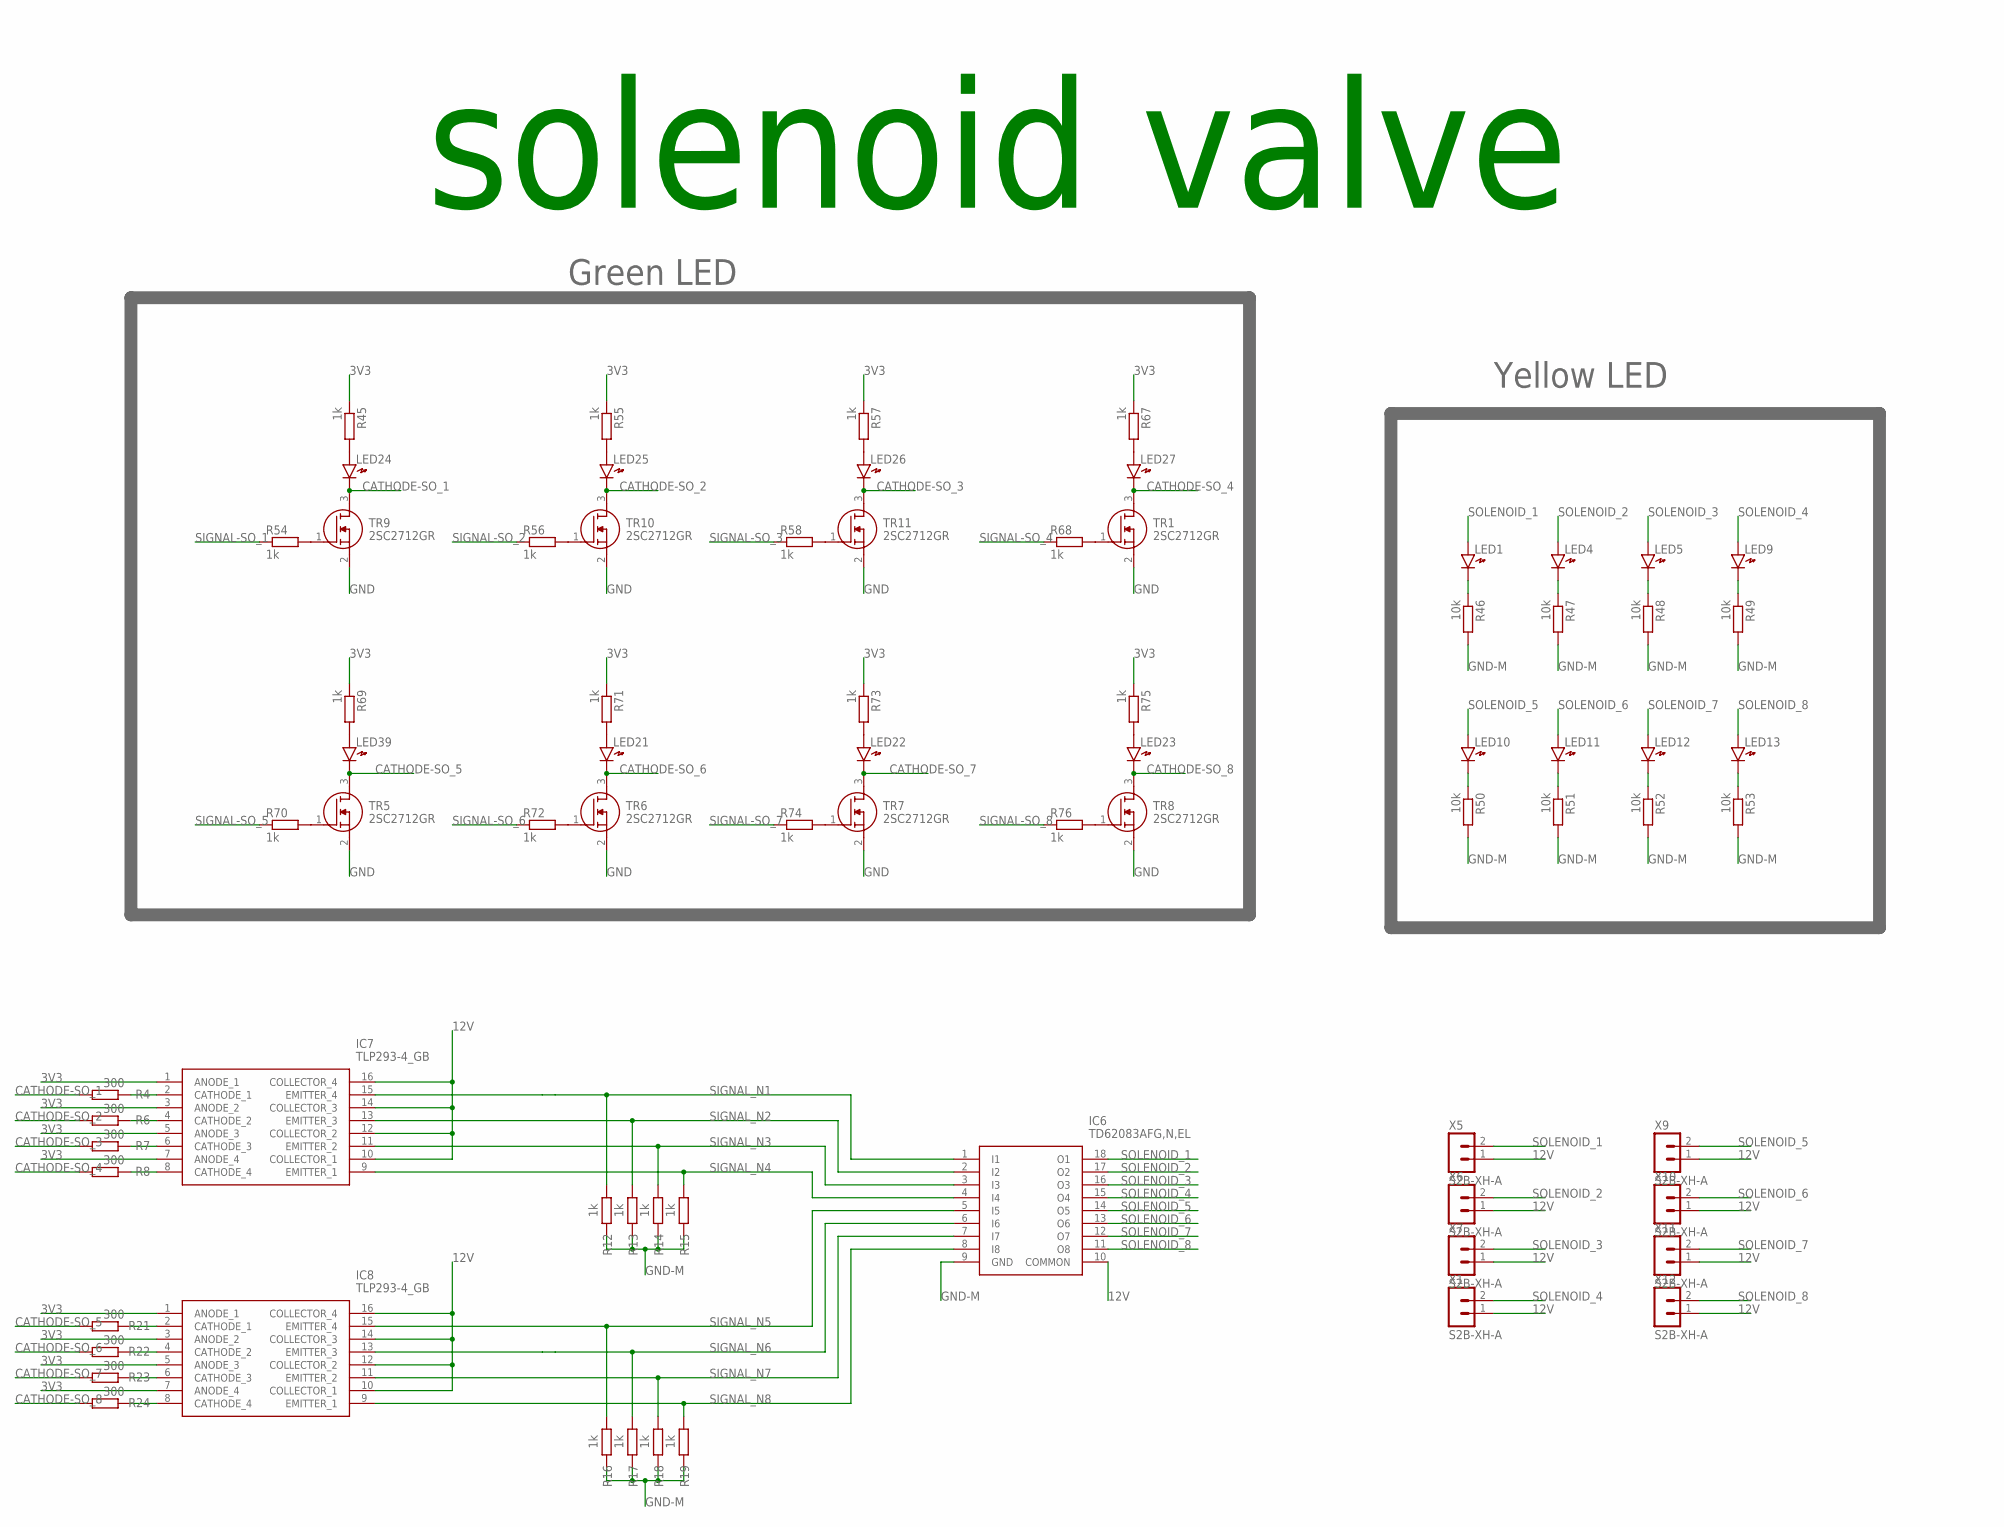
[picture p36: schematic Servosolenoidvalve_of_Tatebayashi.sch, sheet 2]

Parts:
IC6: TD62083AFG,N,EL; SOIC127P1030X245-18N
IC7, IC8: TLP293-4_GB; SOP128P700X220-16N
LED1, LED4, LED5, LED9, LED10, LED11, LED12, LED13, LED21, LED22, LED23, LED24, LED25, LED26, LED27, LED39: LED1608
R4, R6, R7, R8, R21, R22, R23, R24: 300; R0603
R12, R13, R14, R15, R16, R17, R18, R19, R45, R54, R55, R56, R57, R58, R67, R68, R69, R70, R71, R72, R73, R74, R75, R76: 1k; R0603
R46, R47, R48, R49, R50, R51, R52, R53: 10k; R0603
TR1, TR5, TR6, TR7, TR8, TR9, TR10, TR11: 2SC2712GR; SOT-23
X1, X5, X6, X7, X9, X10, X11, X12: S2B-XH-A

Connections:
3V3: IC7.1 (ANODE_1), IC7.3 (ANODE_2), IC7.5 (ANODE_3), IC7.7 (ANODE_4), IC8.1 (ANODE_1), IC8.3 (ANODE_2), IC8.5 (ANODE_3), IC8.7 (ANODE_4), R45.1, R55.1, R57.1, R67.1, R69.1, R71.1, R73.1, R75.1; also elsewhere on the board
12V: IC6.10 (COMMON), IC7.10 (COLLECTOR_1), IC7.12 (COLLECTOR_2), IC7.14 (COLLECTOR_3), IC7.16 (COLLECTOR_4), IC8.10 (COLLECTOR_1), IC8.12 (COLLECTOR_2), IC8.14 (COLLECTOR_3), IC8.16 (COLLECTOR_4), X1.1, X5.1, X6.1, X7.1, X9.1, X10.1, X11.1, X12.1; also elsewhere on the board
CATHODE-SO_1: LED24.K, R4.2, TR9.3 (D)
CATHODE-SO_2: LED25.K, R6.2, TR10.3 (D)
CATHODE-SO_3: LED26.K, R7.2, TR11.3 (D)
CATHODE-SO_4: LED27.K, R8.2, TR1.3 (D)
CATHODE-SO_5: LED39.K, R21.2, TR5.3 (D)
CATHODE-SO_6: LED21.K, R22.2, TR6.3 (D)
CATHODE-SO_7: LED22.K, R23.2, TR7.3 (D)
CATHODE-SO_8: LED23.K, R24.2, TR8.3 (D)
GND: TR1.2 (S), TR5.2 (S), TR6.2 (S), TR7.2 (S), TR8.2 (S), TR9.2 (S), TR10.2 (S), TR11.2 (S); also elsewhere on the board
GND-M: IC6.9 (GND), R12.1, R13.1, R14.1, R15.1, R16.1, R17.1, R18.1, R19.1, R46.2, R47.2, R48.2, R49.2, R50.2, R51.2, R52.2, R53.2; also elsewhere on the board
unnamed: IC7.2 (CATHODE_1), R4.1
unnamed: IC7.4 (CATHODE_2), R6.1
unnamed: IC7.6 (CATHODE_3), R7.1
unnamed: IC7.8 (CATHODE_4), R8.1
unnamed: LED24.A, R45.2
unnamed: LED25.A, R55.2
unnamed: LED26.A, R57.2
unnamed: LED27.A, R67.2
unnamed: IC8.2 (CATHODE_1), R21.1
unnamed: IC8.4 (CATHODE_2), R22.1
unnamed: R54.2, TR9.1 (G)
unnamed: LED39.A, R69.2
unnamed: R68.2, TR1.1 (G)
unnamed: LED21.A, R71.2
unnamed: IC8.6 (CATHODE_3), R23.1
unnamed: IC8.8 (CATHODE_4), R24.1
unnamed: LED22.A, R73.2
unnamed: LED23.A, R75.2
unnamed: R70.2, TR5.1 (G)
unnamed: R72.2, TR6.1 (G)
unnamed: R74.2, TR7.1 (G)
unnamed: R76.2, TR8.1 (G)
unnamed: R56.2, TR10.1 (G)
unnamed: R58.2, TR11.1 (G)
unnamed: LED1.K, R46.1
unnamed: LED4.K, R47.1
unnamed: LED5.K, R48.1
unnamed: LED9.K, R49.1
unnamed: LED10.K, R50.1
unnamed: LED11.K, R51.1
unnamed: LED12.K, R52.1
unnamed: LED13.K, R53.1
SIGNAL-SO_1: R54.1; also elsewhere on the board
SIGNAL-SO_2: R56.1; also elsewhere on the board
SIGNAL-SO_3: R58.1; also elsewhere on the board
SIGNAL-SO_4: R68.1; also elsewhere on the board
SIGNAL-SO_5: R70.1; also elsewhere on the board
SIGNAL-SO_6: R72.1; also elsewhere on the board
SIGNAL-SO_7: R74.1; also elsewhere on the board
SIGNAL-SO_8: R76.1; also elsewhere on the board
SIGNAL_N1: IC6.1 (I1), IC7.15 (EMITTER_4), R12.2
SIGNAL_N2: IC6.2 (I2), IC7.13 (EMITTER_3), R13.2
SIGNAL_N3: IC6.3 (I3), IC7.11 (EMITTER_2), R14.2
SIGNAL_N4: IC6.4 (I4), IC7.9 (EMITTER_1), R15.2
SIGNAL_N5: IC6.5 (I5), IC8.15 (EMITTER_4), R16.2
SIGNAL_N6: IC6.6 (I6), IC8.13 (EMITTER_3), R17.2
SIGNAL_N7: IC6.7 (I7), IC8.11 (EMITTER_2), R18.2
SIGNAL_N8: IC6.8 (I8), IC8.9 (EMITTER_1), R19.2
SOLENOID_1: IC6.18 (O1), LED1.A, X5.2
SOLENOID_2: IC6.17 (O2), LED4.A, X6.2
SOLENOID_3: IC6.16 (O3), LED5.A, X7.2
SOLENOID_4: IC6.15 (O4), LED9.A, X1.2
SOLENOID_5: IC6.14 (O5), LED10.A, X9.2
SOLENOID_6: IC6.13 (O6), LED11.A, X10.2
SOLENOID_7: IC6.12 (O7), LED12.A, X11.2
SOLENOID_8: IC6.11 (O8), LED13.A, X12.2

Notes on the sheet:
solenoid valve
Green LED
Yellow LED
