shinchiryota/Circuit/2022/servo_solenoidvalve_of_Tatebayashi/Servosolenoidvalve_of_Tatebayashi.brd

## EAGLE design 2022/servo_solenoidvalve_of_Tatebayashi/Servosolenoidvalve_of_Tatebayashi.brd (continued)

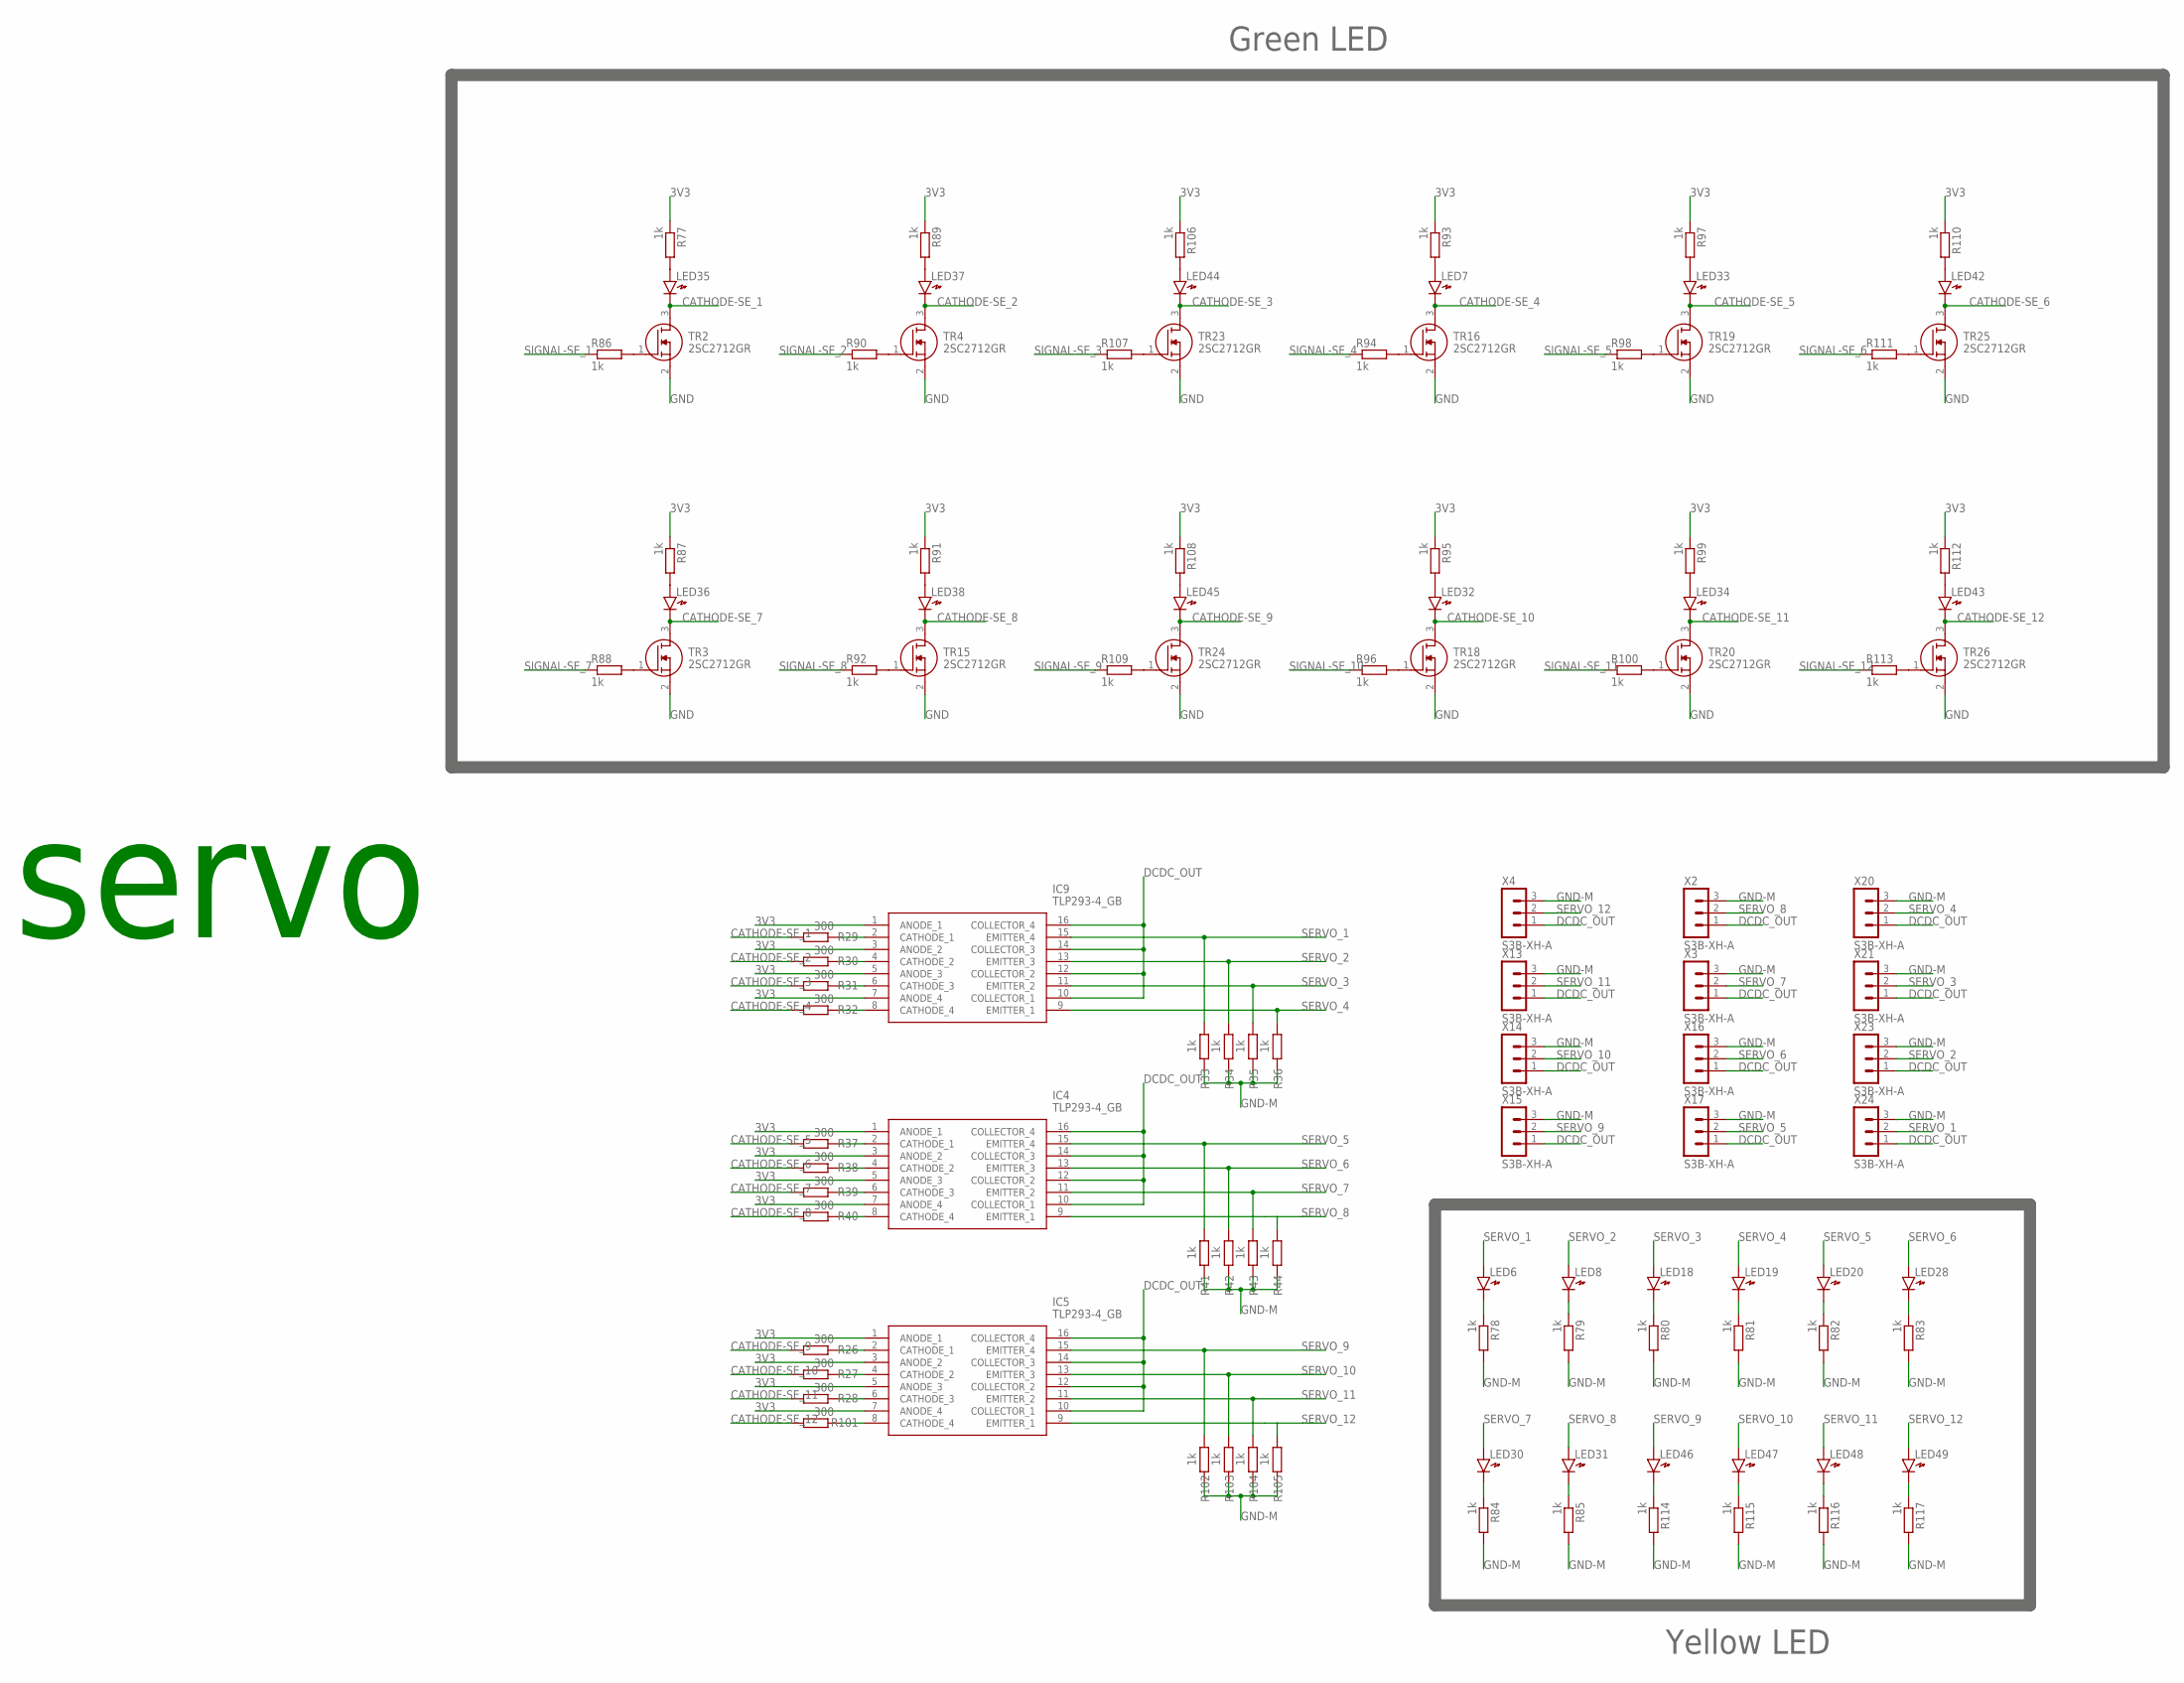
[picture p37: schematic Servosolenoidvalve_of_Tatebayashi.sch, sheet 3]

Parts:
IC4, IC5, IC9: TLP293-4_GB; SOP128P700X220-16N
LED6, LED7, LED8, LED18, LED19, LED20, LED28, LED30, LED31, LED32, LED33, LED34, LED35, LED36, LED37, LED38, LED42, LED43, LED44, LED45, LED46, LED47, LED48, LED49: LED1608
R26, R27, R28, R29, R30, R31, R32, R37, R38, R39, R40, R101: 300; R0603
R33, R34, R35, R36, R41, R42, R43, R44, R77, R78, R79, R80, R81, R82, R83, R84, R85, R86, R87, R88, R89, R90, R91, R92, R93, R94, R95, R96, R97, R98, R99, R100, R102, R103, R104, R105, R106, R107, R108, R109, R110, R111, R112, R113, R114, R115, R116, R117: 1k; R0603
TR2, TR3, TR4, TR15, TR16, TR18, TR19, TR20, TR23, TR24, TR25, TR26: 2SC2712GR; SOT-23
X2, X3, X4, X13, X14, X15, X16, X17, X20, X21, X23, X24: S3B-XH-A

Connections:
3V3: IC4.1 (ANODE_1), IC4.3 (ANODE_2), IC4.5 (ANODE_3), IC4.7 (ANODE_4), IC5.1 (ANODE_1), IC5.3 (ANODE_2), IC5.5 (ANODE_3), IC5.7 (ANODE_4), IC9.1 (ANODE_1), IC9.3 (ANODE_2), IC9.5 (ANODE_3), IC9.7 (ANODE_4), R77.1, R87.1, R89.1, R91.1, R93.1, R95.1, R97.1, R99.1, R106.1, R108.1, R110.1, R112.1; also elsewhere on the board
CATHODE-SE_1: LED35.K, R29.2, TR2.3 (D)
CATHODE-SE_2: LED37.K, R30.2, TR4.3 (D)
CATHODE-SE_3: LED44.K, R31.2, TR23.3 (D)
CATHODE-SE_4: LED7.K, R32.2, TR16.3 (D)
CATHODE-SE_5: LED33.K, R37.2, TR19.3 (D)
CATHODE-SE_6: LED42.K, R38.2, TR25.3 (D)
CATHODE-SE_7: LED36.K, R39.2, TR3.3 (D)
CATHODE-SE_8: LED38.K, R40.2, TR15.3 (D)
CATHODE-SE_9: LED45.K, R26.2, TR24.3 (D)
CATHODE-SE_10: LED32.K, R27.2, TR18.3 (D)
CATHODE-SE_11: LED34.K, R28.2, TR20.3 (D)
CATHODE-SE_12: LED43.K, R101.2, TR26.3 (D)
DCDC_OUT: IC4.10 (COLLECTOR_1), IC4.12 (COLLECTOR_2), IC4.14 (COLLECTOR_3), IC4.16 (COLLECTOR_4), IC5.10 (COLLECTOR_1), IC5.12 (COLLECTOR_2), IC5.14 (COLLECTOR_3), IC5.16 (COLLECTOR_4), IC9.10 (COLLECTOR_1), IC9.12 (COLLECTOR_2), IC9.14 (COLLECTOR_3), IC9.16 (COLLECTOR_4), X2.1, X3.1, X4.1, X13.1, X14.1, X15.1, X16.1, X17.1, X20.1, X21.1, X23.1, X24.1; also elsewhere on the board
GND: TR2.2 (S), TR3.2 (S), TR4.2 (S), TR15.2 (S), TR16.2 (S), TR18.2 (S), TR19.2 (S), TR20.2 (S), TR23.2 (S), TR24.2 (S), TR25.2 (S), TR26.2 (S); also elsewhere on the board
GND-M: R33.1, R34.1, R35.1, R36.1, R41.1, R42.1, R43.1, R44.1, R78.2, R79.2, R80.2, R81.2, R82.2, R83.2, R84.2, R85.2, R102.1, R103.1, R104.1, R105.1, R114.2, R115.2, R116.2, R117.2, X2.3, X3.3, X4.3, X13.3, X14.3, X15.3, X16.3, X17.3, X20.3, X21.3, X23.3, X24.3; also elsewhere on the board
unnamed: IC4.2 (CATHODE_1), R37.1
unnamed: IC4.4 (CATHODE_2), R38.1
unnamed: IC4.6 (CATHODE_3), R39.1
unnamed: IC4.8 (CATHODE_4), R40.1
unnamed: R86.2, TR2.1 (G)
unnamed: R88.2, TR3.1 (G)
unnamed: IC9.2 (CATHODE_1), R29.1
unnamed: IC9.4 (CATHODE_2), R30.1
unnamed: IC9.6 (CATHODE_3), R31.1
unnamed: IC9.8 (CATHODE_4), R32.1
unnamed: R90.2, TR4.1 (G)
unnamed: R92.2, TR15.1 (G)
unnamed: R94.2, TR16.1 (G)
unnamed: R96.2, TR18.1 (G)
unnamed: R98.2, TR19.1 (G)
unnamed: R100.2, TR20.1 (G)
unnamed: IC5.2 (CATHODE_1), R26.1
unnamed: LED6.K, R78.1
unnamed: LED8.K, R79.1
unnamed: LED18.K, R80.1
unnamed: LED19.K, R81.1
unnamed: LED20.K, R82.1
unnamed: LED28.K, R83.1
unnamed: LED30.K, R84.1
unnamed: LED31.K, R85.1
unnamed: LED35.A, R77.2
unnamed: IC5.4 (CATHODE_2), R27.1
unnamed: LED36.A, R87.2
unnamed: IC5.6 (CATHODE_3), R28.1
unnamed: LED37.A, R89.2
unnamed: IC5.8 (CATHODE_4), R101.1
unnamed: LED38.A, R91.2
unnamed: LED7.A, R93.2
unnamed: LED32.A, R95.2
unnamed: LED33.A, R97.2
unnamed: LED34.A, R99.2
unnamed: R107.2, TR23.1 (G)
unnamed: R109.2, TR24.1 (G)
unnamed: R111.2, TR25.1 (G)
unnamed: R113.2, TR26.1 (G)
unnamed: LED44.A, R106.2
unnamed: LED45.A, R108.2
unnamed: LED42.A, R110.2
unnamed: LED43.A, R112.2
unnamed: LED46.K, R114.1
unnamed: LED47.K, R115.1
unnamed: LED48.K, R116.1
unnamed: LED49.K, R117.1
SERVO_1: IC9.15 (EMITTER_4), LED6.A, R33.2, X24.2
SERVO_2: IC9.13 (EMITTER_3), LED8.A, R34.2, X23.2
SERVO_3: IC9.11 (EMITTER_2), LED18.A, R35.2, X21.2
SERVO_4: IC9.9 (EMITTER_1), LED19.A, R36.2, X20.2
SERVO_5: IC4.15 (EMITTER_4), LED20.A, R41.2, X17.2
SERVO_6: IC4.13 (EMITTER_3), LED28.A, R42.2, X16.2
SERVO_7: IC4.11 (EMITTER_2), LED30.A, R43.2, X3.2
SERVO_8: IC4.9 (EMITTER_1), LED31.A, R44.2, X2.2
SERVO_9: IC5.15 (EMITTER_4), LED46.A, R102.2, X15.2
SERVO_10: IC5.13 (EMITTER_3), LED47.A, R103.2, X14.2
SERVO_11: IC5.11 (EMITTER_2), LED48.A, R104.2, X13.2
SERVO_12: IC5.9 (EMITTER_1), LED49.A, R105.2, X4.2
SIGNAL-SE_1: R86.1; also elsewhere on the board
SIGNAL-SE_2: R90.1; also elsewhere on the board
SIGNAL-SE_3: R107.1; also elsewhere on the board
SIGNAL-SE_4: R94.1; also elsewhere on the board
SIGNAL-SE_5: R98.1; also elsewhere on the board
SIGNAL-SE_6: R111.1; also elsewhere on the board
SIGNAL-SE_7: R88.1; also elsewhere on the board
SIGNAL-SE_8: R92.1; also elsewhere on the board
SIGNAL-SE_9: R109.1; also elsewhere on the board
SIGNAL-SE_10: R96.1; also elsewhere on the board
SIGNAL-SE_11: R100.1; also elsewhere on the board
SIGNAL-SE_12: R113.1; also elsewhere on the board

Notes on the sheet:
servo
Yellow LED
Green LED

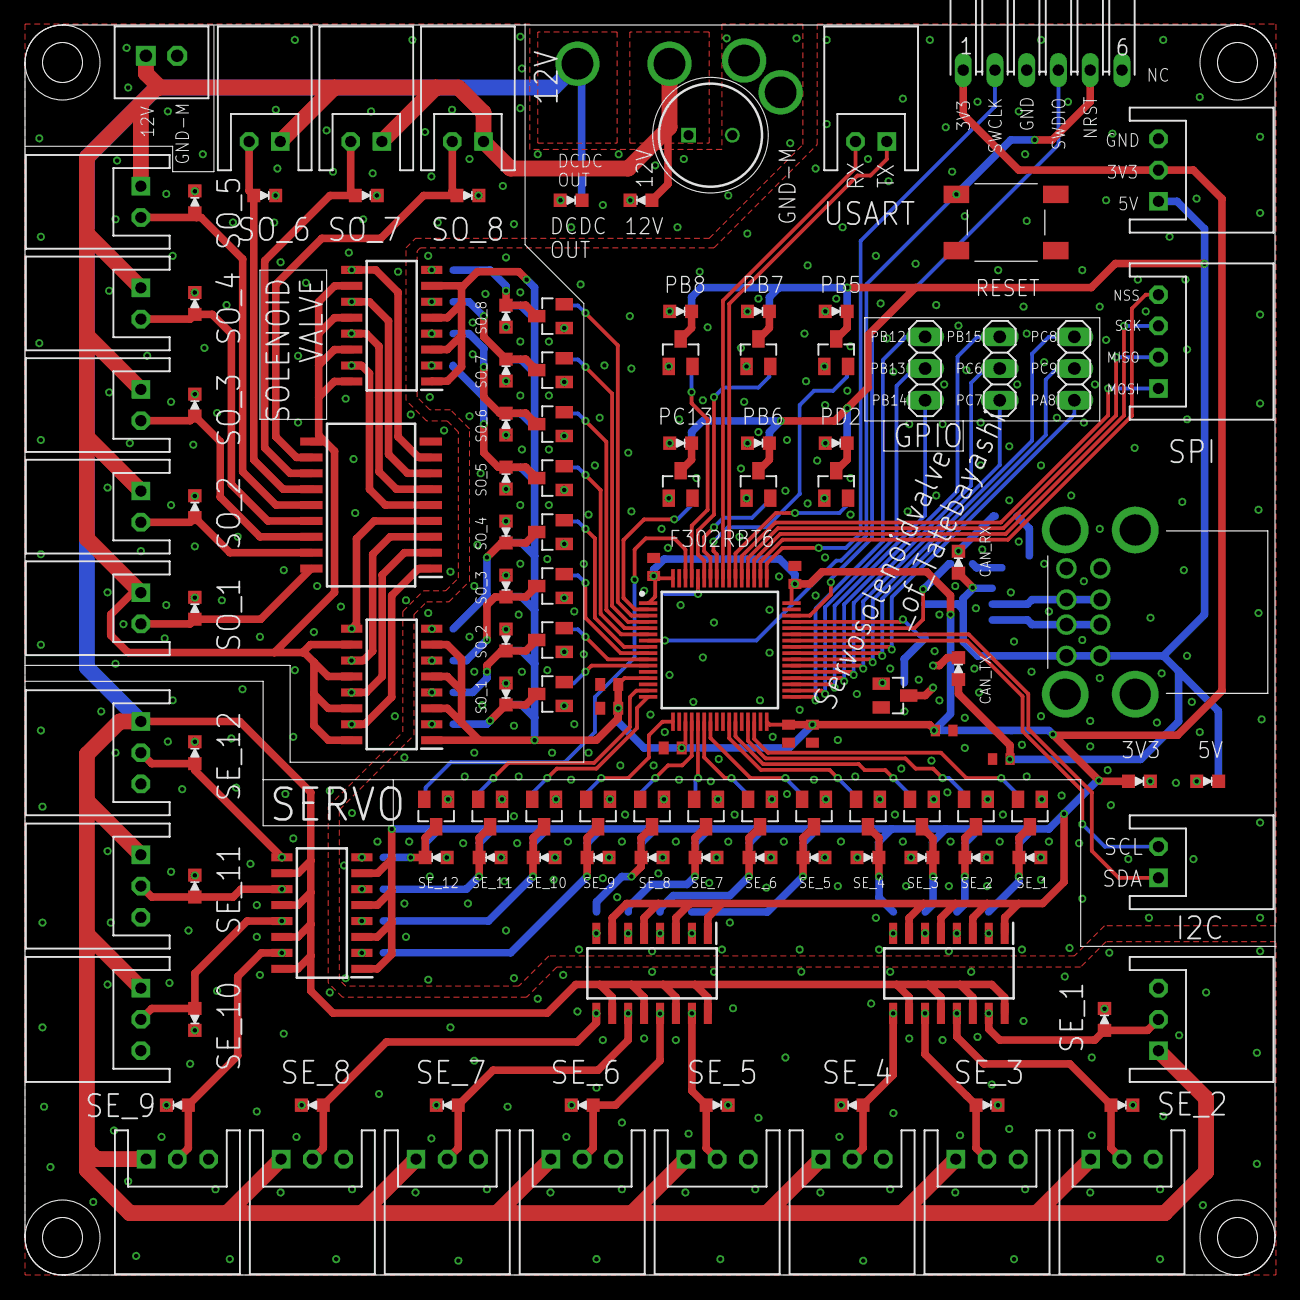
[picture p38: board Servosolenoidvalve_of_Tatebayashi.brd from above]

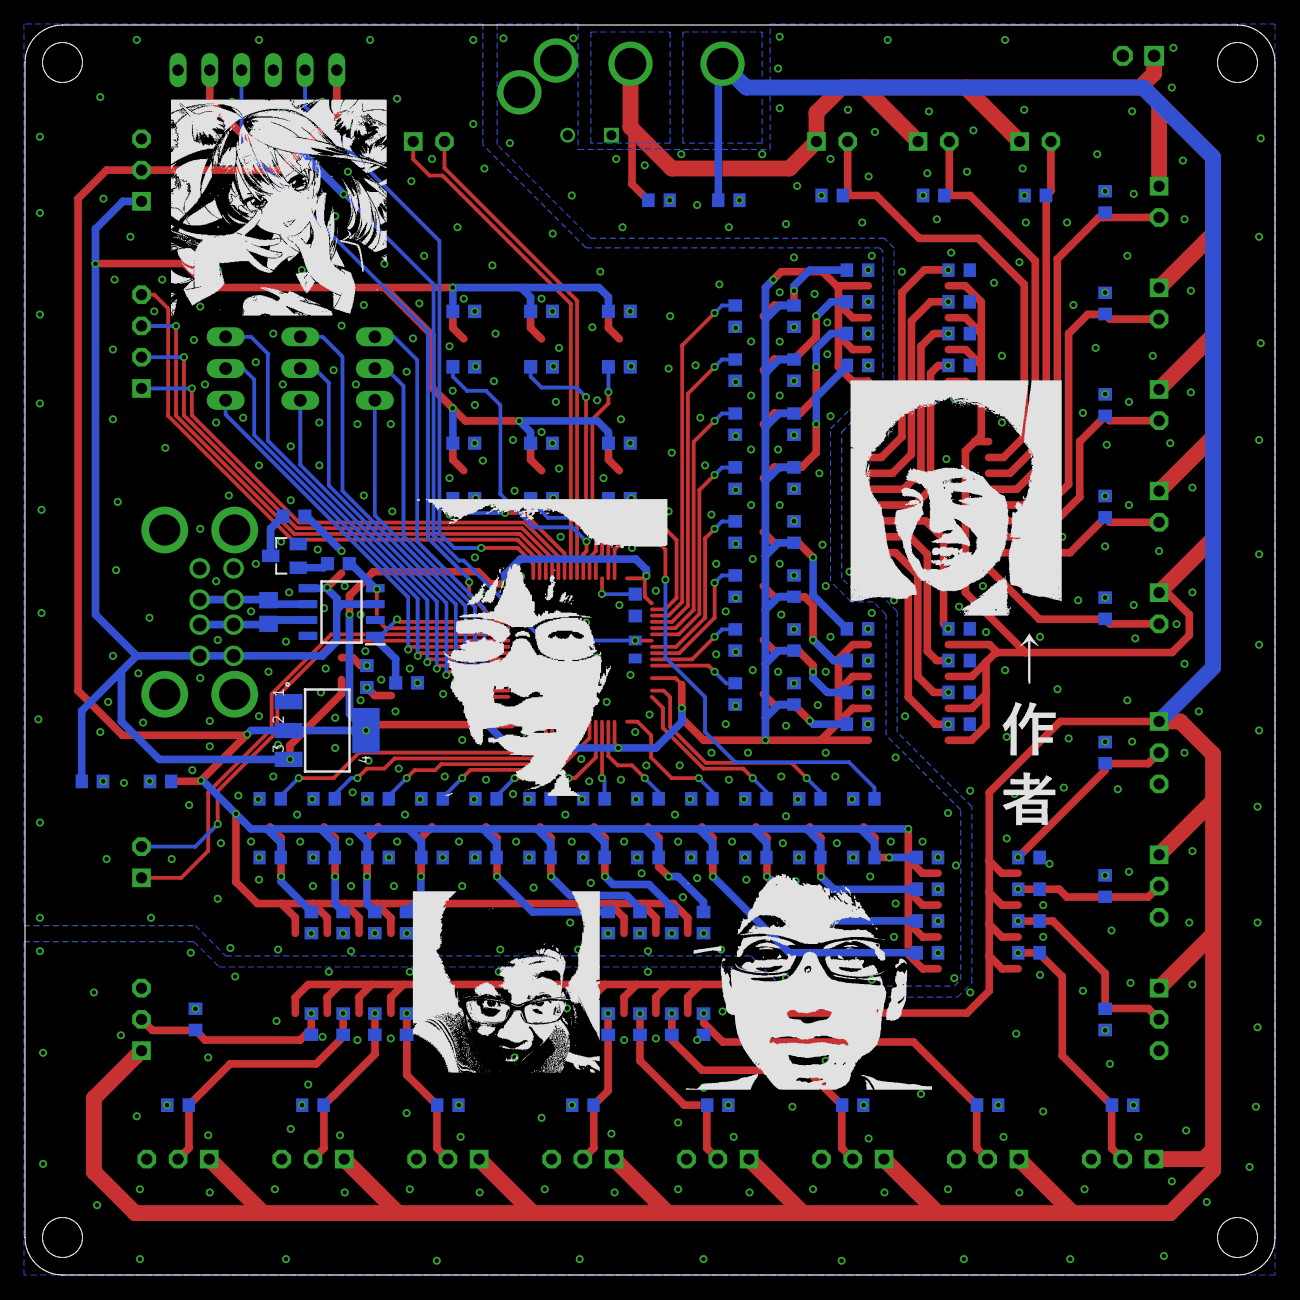
[picture p39: board Servosolenoidvalve_of_Tatebayashi.brd from below]

Board: 2 copper layers, 100.0 x 100.0 mm, 253 parts (126 on the bottom side), 213 nets.
