shinchiryota/Circuit/2022/unitbase_keinz_2022/Unitbase_Keinz_2022.ioc

Mcu.UserName=STM32F732RETx
PA0-WKUP.GPIO_Label=MD5_a
PA0-WKUP.Signal=S_TIM5_CH1
PA1.GPIO_Label=MD5_b
PA1.Signal=S_TIM5_CH2
PA11.Signal=CAN1_RX
PA12.Signal=CAN1_TX
PA13.Signal=SYS_JTMS-SWDIO
PA14.Signal=SYS_JTCK-SWCLK
PA15.Signal=SPI3_NSS
PA2.GPIO_Label=MD2_a
PA2.Signal=S_TIM2_CH3
PA3.GPIO_Label=MD2_b
PA3.Signal=S_TIM2_CH4
PA5.GPIO_Label=MD1_a
PA5.Signal=S_TIM2_CH1_ETR
PA6.GPIO_Label=MD3_a
PA6.Signal=S_TIM3_CH1
PA7.GPIO_Label=MD3_b
PA7.Signal=S_TIM3_CH2
PA8.GPIO_Label=En1a
PA8.Signal=S_TIM1_CH1
PA9.GPIO_Label=En1b
PA9.Signal=S_TIM1_CH2
PB0.GPIO_Label=MD4_a
PB0.Signal=S_TIM3_CH3
PB1.GPIO_Label=MD4_b
PB1.Signal=S_TIM3_CH4
PB10.Signal=I2C2_SCL
PB11.Signal=I2C2_SDA
PB12.Signal=GPIO_Output
PB13.Signal=GPIO_Output
PB14.Signal=GPIO_Output
PB3.GPIO_Label=MD1_b
PB3.Signal=S_TIM2_CH2
PB6.Signal=USART1_TX
PB7.Signal=USART1_RX
PC1.Signal=GPIO_Output
PC10.Signal=SPI3_SCK
PC11.Signal=SPI3_MISO
PC12.Signal=SPI3_MOSI
PC14-OSC32_IN.Signal=GPIO_Output
PC15-OSC32_OUT.Signal=GPIO_Input
PC2.Signal=GPIO_Output
PC3.Signal=GPIO_Output
PC6.GPIO_Label=En2a
PC6.Signal=S_TIM8_CH1
PC7.GPIO_Label=En2b
PC7.Signal=S_TIM8_CH2
PH0-OSC_IN.Signal=GPIO_Output
PH1-OSC_OUT.Signal=GPIO_Output
