shinchiryota/Circuit/(commit log)

2024-04-13 高専ロボコン2024のときに作成された回路を示すフォルダーを作成した
2024-04-13 zipファイルを解凍,ファイルの整備性を良くした
    [Controller_Keinz_2022.brd, Controller_Keinz_2022.csv, Controller_Keinz_2022.sch]
